linkejian123/G9_UofTSARBot/src/Top_Level_Design/bd/Top_Level_Design_BD/hdl/Top_Level_Design_BD.v

//Copyright 1986-2016 Xilinx, Inc. All Rights Reserved.
//--------------------------------------------------------------------------------
//Tool Version: Vivado v.2016.2 (win64) Build 1577090 Thu Jun  2 16:32:40 MDT 2016
//Date        : Mon Apr 10 12:14:05 2017
//Host        : DESKTOP-RL33AL7 running 64-bit major release  (build 9200)
//Command     : generate_target Top_Level_Design_BD.bd
//Design      : Top_Level_Design_BD
//Purpose     : IP block netlist
//--------------------------------------------------------------------------------
`timescale 1 ps / 1 ps

(* CORE_GENERATION_INFO = "Top_Level_Design_BD,IP_Integrator,{x_ipVendor=xilinx.com,x_ipLibrary=BlockDiagram,x_ipName=Top_Level_Design_BD,x_ipVersion=1.00.a,x_ipLanguage=VERILOG,numBlks=30,numReposBlks=19,numNonXlnxBlks=0,numHierBlks=11,maxHierDepth=1,numSysgenBlks=0,numHlsBlks=0,numHdlrefBlks=0,numPkgbdBlks=0,bdsource=USER,da_axi4_cnt=8,da_board_cnt=5,da_mb_cnt=1,synth_mode=Global}" *) (* HW_HANDOFF = "Top_Level_Design_BD.hwdef" *) 
module Top_Level_Design_BD
   (OV7670_D,
    OV7670_HREF,
    OV7670_PCLK,
    OV7670_PWDN,
    OV7670_RESET,
    OV7670_SIOC,
    OV7670_SIOD,
    OV7670_VSYNC,
    OV7670_XCLK,
    TMP_SCL,
    TMP_SDA,
    VGA_Blue,
    VGA_Green,
    VGA_HSYNC,
    VGA_MODE,
    VGA_Red,
    VGA_VSYNC,
    clock_rtl,
    miso,
    mosi,
    reset_rtl,
    reset_rtl_0,
    robot_wheel_driver_1,
    robot_wheel_driver_2,
    robot_wheel_driver_3,
    robot_wheel_driver_4,
    sclk,
    ss,
    uart_rtl_0_rxd,
    uart_rtl_0_txd,
    uart_rtl_rxd,
    uart_rtl_txd,
    vauxn10,
    vauxn11,
    vauxn2,
    vauxn3,
    vauxp10,
    vauxp11,
    vauxp2,
    vauxp3,
    vn_in,
    vp_in);
  input [7:0]OV7670_D;
  input OV7670_HREF;
  input OV7670_PCLK;
  output OV7670_PWDN;
  output OV7670_RESET;
  output OV7670_SIOC;
  inout OV7670_SIOD;
  input OV7670_VSYNC;
  output OV7670_XCLK;
  inout TMP_SCL;
  inout TMP_SDA;
  output [3:0]VGA_Blue;
  output [3:0]VGA_Green;
  output VGA_HSYNC;
  input VGA_MODE;
  output [3:0]VGA_Red;
  output VGA_VSYNC;
  input clock_rtl;
  input miso;
  output mosi;
  input reset_rtl;
  input reset_rtl_0;
  output [1:0]robot_wheel_driver_1;
  output [1:0]robot_wheel_driver_2;
  output [1:0]robot_wheel_driver_3;
  output [1:0]robot_wheel_driver_4;
  output sclk;
  output ss;
  input uart_rtl_0_rxd;
  output uart_rtl_0_txd;
  input uart_rtl_rxd;
  output uart_rtl_txd;
  input vauxn10;
  input vauxn11;
  input vauxn2;
  input vauxn3;
  input vauxp10;
  input vauxp11;
  input vauxp2;
  input vauxp3;
  input vn_in;
  input vp_in;

  wire Accelerometer_0_mosi;
  wire Accelerometer_0_sclk;
  wire Accelerometer_0_ss;
  wire Net;
  wire Net1;
  wire Net2;
  wire [7:0]OV7670_D_1;
  wire OV7670_HREF_1;
  wire OV7670_PCLK_1;
  wire OV7670_VGA_0_OV7670_PWDN;
  wire OV7670_VGA_0_OV7670_RESET;
  wire OV7670_VGA_0_OV7670_SIOC;
  wire OV7670_VGA_0_OV7670_XCLK;
  wire [3:0]OV7670_VGA_0_VGA_Blue;
  wire [3:0]OV7670_VGA_0_VGA_Green;
  wire OV7670_VGA_0_VGA_HSYNC;
  wire [3:0]OV7670_VGA_0_VGA_Red;
  wire OV7670_VGA_0_VGA_VSYNC;
  wire OV7670_VSYNC_1;
  wire [1:0]Robot_Controller_0_robot_wheel_driver_1;
  wire [1:0]Robot_Controller_0_robot_wheel_driver_2;
  wire [1:0]Robot_Controller_0_robot_wheel_driver_3;
  wire [1:0]Robot_Controller_0_robot_wheel_driver_4;
  wire VGA_MODE_1;
  wire axi_uartlite_0_UART_RxD;
  wire axi_uartlite_0_UART_TxD;
  wire axi_uartlite_0_interrupt;
  wire axi_uartlite_1_UART_RxD;
  wire axi_uartlite_1_UART_TxD;
  wire axi_uartlite_1_interrupt;
  wire clk_wiz_1_locked;
  wire clock_rtl_1;
  wire mdm_1_debug_sys_rst;
  wire microblaze_0_Clk;
  wire [31:0]microblaze_0_axi_dp_ARADDR;
  wire [2:0]microblaze_0_axi_dp_ARPROT;
  wire [0:0]microblaze_0_axi_dp_ARREADY;
  wire microblaze_0_axi_dp_ARVALID;
  wire [31:0]microblaze_0_axi_dp_AWADDR;
  wire [2:0]microblaze_0_axi_dp_AWPROT;
  wire [0:0]microblaze_0_axi_dp_AWREADY;
  wire microblaze_0_axi_dp_AWVALID;
  wire microblaze_0_axi_dp_BREADY;
  wire [1:0]microblaze_0_axi_dp_BRESP;
  wire [0:0]microblaze_0_axi_dp_BVALID;
  wire [31:0]microblaze_0_axi_dp_RDATA;
  wire microblaze_0_axi_dp_RREADY;
  wire [1:0]microblaze_0_axi_dp_RRESP;
  wire [0:0]microblaze_0_axi_dp_RVALID;
  wire [31:0]microblaze_0_axi_dp_WDATA;
  wire [0:0]microblaze_0_axi_dp_WREADY;
  wire [3:0]microblaze_0_axi_dp_WSTRB;
  wire microblaze_0_axi_dp_WVALID;
  wire [31:0]microblaze_0_axi_periph_M01_AXI_ARADDR;
  wire [2:0]microblaze_0_axi_periph_M01_AXI_ARPROT;
  wire microblaze_0_axi_periph_M01_AXI_ARREADY;
  wire microblaze_0_axi_periph_M01_AXI_ARVALID;
  wire [31:0]microblaze_0_axi_periph_M01_AXI_AWADDR;
  wire [2:0]microblaze_0_axi_periph_M01_AXI_AWPROT;
  wire microblaze_0_axi_periph_M01_AXI_AWREADY;
  wire microblaze_0_axi_periph_M01_AXI_AWVALID;
  wire microblaze_0_axi_periph_M01_AXI_BREADY;
  wire [1:0]microblaze_0_axi_periph_M01_AXI_BRESP;
  wire microblaze_0_axi_periph_M01_AXI_BVALID;
  wire [31:0]microblaze_0_axi_periph_M01_AXI_RDATA;
  wire microblaze_0_axi_periph_M01_AXI_RREADY;
  wire [1:0]microblaze_0_axi_periph_M01_AXI_RRESP;
  wire microblaze_0_axi_periph_M01_AXI_RVALID;
  wire [31:0]microblaze_0_axi_periph_M01_AXI_WDATA;
  wire microblaze_0_axi_periph_M01_AXI_WREADY;
  wire [3:0]microblaze_0_axi_periph_M01_AXI_WSTRB;
  wire microblaze_0_axi_periph_M01_AXI_WVALID;
  wire [31:0]microblaze_0_axi_periph_M02_AXI_ARADDR;
  wire [2:0]microblaze_0_axi_periph_M02_AXI_ARPROT;
  wire microblaze_0_axi_periph_M02_AXI_ARREADY;
  wire microblaze_0_axi_periph_M02_AXI_ARVALID;
  wire [31:0]microblaze_0_axi_periph_M02_AXI_AWADDR;
  wire [2:0]microblaze_0_axi_periph_M02_AXI_AWPROT;
  wire microblaze_0_axi_periph_M02_AXI_AWREADY;
  wire microblaze_0_axi_periph_M02_AXI_AWVALID;
  wire microblaze_0_axi_periph_M02_AXI_BREADY;
  wire [1:0]microblaze_0_axi_periph_M02_AXI_BRESP;
  wire microblaze_0_axi_periph_M02_AXI_BVALID;
  wire [31:0]microblaze_0_axi_periph_M02_AXI_RDATA;
  wire microblaze_0_axi_periph_M02_AXI_RREADY;
  wire [1:0]microblaze_0_axi_periph_M02_AXI_RRESP;
  wire microblaze_0_axi_periph_M02_AXI_RVALID;
  wire [31:0]microblaze_0_axi_periph_M02_AXI_WDATA;
  wire microblaze_0_axi_periph_M02_AXI_WREADY;
  wire [3:0]microblaze_0_axi_periph_M02_AXI_WSTRB;
  wire microblaze_0_axi_periph_M02_AXI_WVALID;
  wire [31:0]microblaze_0_axi_periph_M03_AXI_ARADDR;
  wire [2:0]microblaze_0_axi_periph_M03_AXI_ARPROT;
  wire microblaze_0_axi_periph_M03_AXI_ARREADY;
  wire microblaze_0_axi_periph_M03_AXI_ARVALID;
  wire [31:0]microblaze_0_axi_periph_M03_AXI_AWADDR;
  wire [2:0]microblaze_0_axi_periph_M03_AXI_AWPROT;
  wire microblaze_0_axi_periph_M03_AXI_AWREADY;
  wire microblaze_0_axi_periph_M03_AXI_AWVALID;
  wire microblaze_0_axi_periph_M03_AXI_BREADY;
  wire [1:0]microblaze_0_axi_periph_M03_AXI_BRESP;
  wire microblaze_0_axi_periph_M03_AXI_BVALID;
  wire [31:0]microblaze_0_axi_periph_M03_AXI_RDATA;
  wire microblaze_0_axi_periph_M03_AXI_RREADY;
  wire [1:0]microblaze_0_axi_periph_M03_AXI_RRESP;
  wire microblaze_0_axi_periph_M03_AXI_RVALID;
  wire [31:0]microblaze_0_axi_periph_M03_AXI_WDATA;
  wire microblaze_0_axi_periph_M03_AXI_WREADY;
  wire [3:0]microblaze_0_axi_periph_M03_AXI_WSTRB;
  wire microblaze_0_axi_periph_M03_AXI_WVALID;
  wire [31:0]microblaze_0_axi_periph_M04_AXI_ARADDR;
  wire [2:0]microblaze_0_axi_periph_M04_AXI_ARPROT;
  wire microblaze_0_axi_periph_M04_AXI_ARREADY;
  wire microblaze_0_axi_periph_M04_AXI_ARVALID;
  wire [31:0]microblaze_0_axi_periph_M04_AXI_AWADDR;
  wire [2:0]microblaze_0_axi_periph_M04_AXI_AWPROT;
  wire microblaze_0_axi_periph_M04_AXI_AWREADY;
  wire microblaze_0_axi_periph_M04_AXI_AWVALID;
  wire microblaze_0_axi_periph_M04_AXI_BREADY;
  wire [1:0]microblaze_0_axi_periph_M04_AXI_BRESP;
  wire microblaze_0_axi_periph_M04_AXI_BVALID;
  wire [31:0]microblaze_0_axi_periph_M04_AXI_RDATA;
  wire microblaze_0_axi_periph_M04_AXI_RREADY;
  wire [1:0]microblaze_0_axi_periph_M04_AXI_RRESP;
  wire microblaze_0_axi_periph_M04_AXI_RVALID;
  wire [31:0]microblaze_0_axi_periph_M04_AXI_WDATA;
  wire microblaze_0_axi_periph_M04_AXI_WREADY;
  wire [3:0]microblaze_0_axi_periph_M04_AXI_WSTRB;
  wire microblaze_0_axi_periph_M04_AXI_WVALID;
  wire [31:0]microblaze_0_axi_periph_M05_AXI_ARADDR;
  wire [2:0]microblaze_0_axi_periph_M05_AXI_ARPROT;
  wire microblaze_0_axi_periph_M05_AXI_ARREADY;
  wire microblaze_0_axi_periph_M05_AXI_ARVALID;
  wire [31:0]microblaze_0_axi_periph_M05_AXI_AWADDR;
  wire [2:0]microblaze_0_axi_periph_M05_AXI_AWPROT;
  wire microblaze_0_axi_periph_M05_AXI_AWREADY;
  wire microblaze_0_axi_periph_M05_AXI_AWVALID;
  wire microblaze_0_axi_periph_M05_AXI_BREADY;
  wire [1:0]microblaze_0_axi_periph_M05_AXI_BRESP;
  wire microblaze_0_axi_periph_M05_AXI_BVALID;
  wire [31:0]microblaze_0_axi_periph_M05_AXI_RDATA;
  wire microblaze_0_axi_periph_M05_AXI_RREADY;
  wire [1:0]microblaze_0_axi_periph_M05_AXI_RRESP;
  wire microblaze_0_axi_periph_M05_AXI_RVALID;
  wire [31:0]microblaze_0_axi_periph_M05_AXI_WDATA;
  wire microblaze_0_axi_periph_M05_AXI_WREADY;
  wire [3:0]microblaze_0_axi_periph_M05_AXI_WSTRB;
  wire microblaze_0_axi_periph_M05_AXI_WVALID;
  wire [31:0]microblaze_0_axi_periph_M06_AXI_ARADDR;
  wire microblaze_0_axi_periph_M06_AXI_ARREADY;
  wire microblaze_0_axi_periph_M06_AXI_ARVALID;
  wire [31:0]microblaze_0_axi_periph_M06_AXI_AWADDR;
  wire microblaze_0_axi_periph_M06_AXI_AWREADY;
  wire microblaze_0_axi_periph_M06_AXI_AWVALID;
  wire microblaze_0_axi_periph_M06_AXI_BREADY;
  wire [1:0]microblaze_0_axi_periph_M06_AXI_BRESP;
  wire microblaze_0_axi_periph_M06_AXI_BVALID;
  wire [31:0]microblaze_0_axi_periph_M06_AXI_RDATA;
  wire microblaze_0_axi_periph_M06_AXI_RREADY;
  wire [1:0]microblaze_0_axi_periph_M06_AXI_RRESP;
  wire microblaze_0_axi_periph_M06_AXI_RVALID;
  wire [31:0]microblaze_0_axi_periph_M06_AXI_WDATA;
  wire microblaze_0_axi_periph_M06_AXI_WREADY;
  wire [3:0]microblaze_0_axi_periph_M06_AXI_WSTRB;
  wire microblaze_0_axi_periph_M06_AXI_WVALID;
  wire [31:0]microblaze_0_axi_periph_M07_AXI_ARADDR;
  wire microblaze_0_axi_periph_M07_AXI_ARREADY;
  wire microblaze_0_axi_periph_M07_AXI_ARVALID;
  wire [31:0]microblaze_0_axi_periph_M07_AXI_AWADDR;
  wire microblaze_0_axi_periph_M07_AXI_AWREADY;
  wire microblaze_0_axi_periph_M07_AXI_AWVALID;
  wire microblaze_0_axi_periph_M07_AXI_BREADY;
  wire [1:0]microblaze_0_axi_periph_M07_AXI_BRESP;
  wire microblaze_0_axi_periph_M07_AXI_BVALID;
  wire [31:0]microblaze_0_axi_periph_M07_AXI_RDATA;
  wire microblaze_0_axi_periph_M07_AXI_RREADY;
  wire [1:0]microblaze_0_axi_periph_M07_AXI_RRESP;
  wire microblaze_0_axi_periph_M07_AXI_RVALID;
  wire [31:0]microblaze_0_axi_periph_M07_AXI_WDATA;
  wire microblaze_0_axi_periph_M07_AXI_WREADY;
  wire [3:0]microblaze_0_axi_periph_M07_AXI_WSTRB;
  wire microblaze_0_axi_periph_M07_AXI_WVALID;
  wire microblaze_0_debug_CAPTURE;
  wire microblaze_0_debug_CLK;
  wire [0:7]microblaze_0_debug_REG_EN;
  wire microblaze_0_debug_RST;
  wire microblaze_0_debug_SHIFT;
  wire microblaze_0_debug_TDI;
  wire microblaze_0_debug_TDO;
  wire microblaze_0_debug_UPDATE;
  wire [0:31]microblaze_0_dlmb_1_ABUS;
  wire microblaze_0_dlmb_1_ADDRSTROBE;
  wire [0:3]microblaze_0_dlmb_1_BE;
  wire microblaze_0_dlmb_1_CE;
  wire [0:31]microblaze_0_dlmb_1_READDBUS;
  wire microblaze_0_dlmb_1_READSTROBE;
  wire microblaze_0_dlmb_1_READY;
  wire microblaze_0_dlmb_1_UE;
  wire microblaze_0_dlmb_1_WAIT;
  wire [0:31]microblaze_0_dlmb_1_WRITEDBUS;
  wire microblaze_0_dlmb_1_WRITESTROBE;
  wire [0:31]microblaze_0_ilmb_1_ABUS;
  wire microblaze_0_ilmb_1_ADDRSTROBE;
  wire microblaze_0_ilmb_1_CE;
  wire [0:31]microblaze_0_ilmb_1_READDBUS;
  wire microblaze_0_ilmb_1_READSTROBE;
  wire microblaze_0_ilmb_1_READY;
  wire microblaze_0_ilmb_1_UE;
  wire microblaze_0_ilmb_1_WAIT;
  wire [31:0]microblaze_0_intc_axi_ARADDR;
  wire microblaze_0_intc_axi_ARREADY;
  wire microblaze_0_intc_axi_ARVALID;
  wire [31:0]microblaze_0_intc_axi_AWADDR;
  wire microblaze_0_intc_axi_AWREADY;
  wire microblaze_0_intc_axi_AWVALID;
  wire microblaze_0_intc_axi_BREADY;
  wire [1:0]microblaze_0_intc_axi_BRESP;
  wire microblaze_0_intc_axi_BVALID;
  wire [31:0]microblaze_0_intc_axi_RDATA;
  wire microblaze_0_intc_axi_RREADY;
  wire [1:0]microblaze_0_intc_axi_RRESP;
  wire microblaze_0_intc_axi_RVALID;
  wire [31:0]microblaze_0_intc_axi_WDATA;
  wire microblaze_0_intc_axi_WREADY;
  wire [3:0]microblaze_0_intc_axi_WSTRB;
  wire microblaze_0_intc_axi_WVALID;
  wire [0:1]microblaze_0_interrupt_ACK;
  wire [31:0]microblaze_0_interrupt_ADDRESS;
  wire microblaze_0_interrupt_INTERRUPT;
  wire [1:0]microblaze_0_intr;
  wire miso_1;
  wire reset_rtl_0_1;
  wire reset_rtl_1;
  wire [0:0]rst_clk_wiz_1_100M_bus_struct_reset;
  wire [0:0]rst_clk_wiz_1_100M_interconnect_aresetn;
  wire rst_clk_wiz_1_100M_mb_reset;
  wire [0:0]rst_clk_wiz_1_100M_peripheral_aresetn;
  wire vauxn10_1;
  wire vauxn11_1;
  wire vauxn2_1;
  wire vauxn3_1;
  wire vauxp10_1;
  wire vauxp11_1;
  wire vauxp2_1;
  wire vauxp3_1;
  wire vn_in_1;
  wire vp_in_1;

  assign OV7670_D_1 = OV7670_D[7:0];
  assign OV7670_HREF_1 = OV7670_HREF;
  assign OV7670_PCLK_1 = OV7670_PCLK;
  assign OV7670_PWDN = OV7670_VGA_0_OV7670_PWDN;
  assign OV7670_RESET = OV7670_VGA_0_OV7670_RESET;
  assign OV7670_SIOC = OV7670_VGA_0_OV7670_SIOC;
  assign OV7670_VSYNC_1 = OV7670_VSYNC;
  assign OV7670_XCLK = OV7670_VGA_0_OV7670_XCLK;
  assign VGA_Blue[3:0] = OV7670_VGA_0_VGA_Blue;
  assign VGA_Green[3:0] = OV7670_VGA_0_VGA_Green;
  assign VGA_HSYNC = OV7670_VGA_0_VGA_HSYNC;
  assign VGA_MODE_1 = VGA_MODE;
  assign VGA_Red[3:0] = OV7670_VGA_0_VGA_Red;
  assign VGA_VSYNC = OV7670_VGA_0_VGA_VSYNC;
  assign axi_uartlite_0_UART_RxD = uart_rtl_rxd;
  assign axi_uartlite_1_UART_RxD = uart_rtl_0_rxd;
  assign clock_rtl_1 = clock_rtl;
  assign miso_1 = miso;
  assign mosi = Accelerometer_0_mosi;
  assign reset_rtl_0_1 = reset_rtl_0;
  assign reset_rtl_1 = reset_rtl;
  assign robot_wheel_driver_1[1:0] = Robot_Controller_0_robot_wheel_driver_1;
  assign robot_wheel_driver_2[1:0] = Robot_Controller_0_robot_wheel_driver_2;
  assign robot_wheel_driver_3[1:0] = Robot_Controller_0_robot_wheel_driver_3;
  assign robot_wheel_driver_4[1:0] = Robot_Controller_0_robot_wheel_driver_4;
  assign sclk = Accelerometer_0_sclk;
  assign ss = Accelerometer_0_ss;
  assign uart_rtl_0_txd = axi_uartlite_1_UART_TxD;
  assign uart_rtl_txd = axi_uartlite_0_UART_TxD;
  assign vauxn10_1 = vauxn10;
  assign vauxn11_1 = vauxn11;
  assign vauxn2_1 = vauxn2;
  assign vauxn3_1 = vauxn3;
  assign vauxp10_1 = vauxp10;
  assign vauxp11_1 = vauxp11;
  assign vauxp2_1 = vauxp2;
  assign vauxp3_1 = vauxp3;
  assign vn_in_1 = vn_in;
  assign vp_in_1 = vp_in;
  Top_Level_Design_BD_Accelerometer_0_0 Accelerometer_0
       (.accelerometer_axi_aclk(microblaze_0_Clk),
        .accelerometer_axi_araddr(microblaze_0_axi_periph_M04_AXI_ARADDR[3:0]),
        .accelerometer_axi_aresetn(rst_clk_wiz_1_100M_peripheral_aresetn),
        .accelerometer_axi_arprot(microblaze_0_axi_periph_M04_AXI_ARPROT),
        .accelerometer_axi_arready(microblaze_0_axi_periph_M04_AXI_ARREADY),
        .accelerometer_axi_arvalid(microblaze_0_axi_periph_M04_AXI_ARVALID),
        .accelerometer_axi_awaddr(microblaze_0_axi_periph_M04_AXI_AWADDR[3:0]),
        .accelerometer_axi_awprot(microblaze_0_axi_periph_M04_AXI_AWPROT),
        .accelerometer_axi_awready(microblaze_0_axi_periph_M04_AXI_AWREADY),
        .accelerometer_axi_awvalid(microblaze_0_axi_periph_M04_AXI_AWVALID),
        .accelerometer_axi_bready(microblaze_0_axi_periph_M04_AXI_BREADY),
        .accelerometer_axi_bresp(microblaze_0_axi_periph_M04_AXI_BRESP),
        .accelerometer_axi_bvalid(microblaze_0_axi_periph_M04_AXI_BVALID),
        .accelerometer_axi_rdata(microblaze_0_axi_periph_M04_AXI_RDATA),
        .accelerometer_axi_rready(microblaze_0_axi_periph_M04_AXI_RREADY),
        .accelerometer_axi_rresp(microblaze_0_axi_periph_M04_AXI_RRESP),
        .accelerometer_axi_rvalid(microblaze_0_axi_periph_M04_AXI_RVALID),
        .accelerometer_axi_wdata(microblaze_0_axi_periph_M04_AXI_WDATA),
        .accelerometer_axi_wready(microblaze_0_axi_periph_M04_AXI_WREADY),
        .accelerometer_axi_wstrb(microblaze_0_axi_periph_M04_AXI_WSTRB),
        .accelerometer_axi_wvalid(microblaze_0_axi_periph_M04_AXI_WVALID),
        .miso(miso_1),
        .mosi(Accelerometer_0_mosi),
        .sclk(Accelerometer_0_sclk),
        .ss(Accelerometer_0_ss));
  Top_Level_Design_BD_OV7670_VGA_0_0 OV7670_VGA_0
       (.OV7670_D(OV7670_D_1),
        .OV7670_HREF(OV7670_HREF_1),
        .OV7670_PCLK(OV7670_PCLK_1),
        .OV7670_PWDN(OV7670_VGA_0_OV7670_PWDN),
        .OV7670_RESET(OV7670_VGA_0_OV7670_RESET),
        .OV7670_SIOC(OV7670_VGA_0_OV7670_SIOC),
        .OV7670_SIOD(OV7670_SIOD),
        .OV7670_VSYNC(OV7670_VSYNC_1),
        .OV7670_XCLK(OV7670_VGA_0_OV7670_XCLK),
        .VGA_Blue(OV7670_VGA_0_VGA_Blue),
        .VGA_Green(OV7670_VGA_0_VGA_Green),
        .VGA_HSYNC(OV7670_VGA_0_VGA_HSYNC),
        .VGA_MODE(VGA_MODE_1),
        .VGA_Red(OV7670_VGA_0_VGA_Red),
        .VGA_VSYNC(OV7670_VGA_0_VGA_VSYNC),
        .ov7670_vga_axi_aclk(microblaze_0_Clk),
        .ov7670_vga_axi_araddr(microblaze_0_axi_periph_M02_AXI_ARADDR[3:0]),
        .ov7670_vga_axi_aresetn(rst_clk_wiz_1_100M_peripheral_aresetn),
        .ov7670_vga_axi_arprot(microblaze_0_axi_periph_M02_AXI_ARPROT),
        .ov7670_vga_axi_arready(microblaze_0_axi_periph_M02_AXI_ARREADY),
        .ov7670_vga_axi_arvalid(microblaze_0_axi_periph_M02_AXI_ARVALID),
        .ov7670_vga_axi_awaddr(microblaze_0_axi_periph_M02_AXI_AWADDR[3:0]),
        .ov7670_vga_axi_awprot(microblaze_0_axi_periph_M02_AXI_AWPROT),
        .ov7670_vga_axi_awready(microblaze_0_axi_periph_M02_AXI_AWREADY),
        .ov7670_vga_axi_awvalid(microblaze_0_axi_periph_M02_AXI_AWVALID),
        .ov7670_vga_axi_bready(microblaze_0_axi_periph_M02_AXI_BREADY),
        .ov7670_vga_axi_bresp(microblaze_0_axi_periph_M02_AXI_BRESP),
        .ov7670_vga_axi_bvalid(microblaze_0_axi_periph_M02_AXI_BVALID),
        .ov7670_vga_axi_rdata(microblaze_0_axi_periph_M02_AXI_RDATA),
        .ov7670_vga_axi_rready(microblaze_0_axi_periph_M02_AXI_RREADY),
        .ov7670_vga_axi_rresp(microblaze_0_axi_periph_M02_AXI_RRESP),
        .ov7670_vga_axi_rvalid(microblaze_0_axi_periph_M02_AXI_RVALID),
        .ov7670_vga_axi_wdata(microblaze_0_axi_periph_M02_AXI_WDATA),
        .ov7670_vga_axi_wready(microblaze_0_axi_periph_M02_AXI_WREADY),
        .ov7670_vga_axi_wstrb(microblaze_0_axi_periph_M02_AXI_WSTRB),
        .ov7670_vga_axi_wvalid(microblaze_0_axi_periph_M02_AXI_WVALID));
  Top_Level_Design_BD_Robot_Controller_0_0 Robot_Controller_0
       (.robot_controller_axi_aclk(microblaze_0_Clk),
        .robot_controller_axi_araddr(microblaze_0_axi_periph_M01_AXI_ARADDR[4:0]),
        .robot_controller_axi_aresetn(rst_clk_wiz_1_100M_peripheral_aresetn),
        .robot_controller_axi_arprot(microblaze_0_axi_periph_M01_AXI_ARPROT),
        .robot_controller_axi_arready(microblaze_0_axi_periph_M01_AXI_ARREADY),
        .robot_controller_axi_arvalid(microblaze_0_axi_periph_M01_AXI_ARVALID),
        .robot_controller_axi_awaddr(microblaze_0_axi_periph_M01_AXI_AWADDR[4:0]),
        .robot_controller_axi_awprot(microblaze_0_axi_periph_M01_AXI_AWPROT),
        .robot_controller_axi_awready(microblaze_0_axi_periph_M01_AXI_AWREADY),
        .robot_controller_axi_awvalid(microblaze_0_axi_periph_M01_AXI_AWVALID),
        .robot_controller_axi_bready(microblaze_0_axi_periph_M01_AXI_BREADY),
        .robot_controller_axi_bresp(microblaze_0_axi_periph_M01_AXI_BRESP),
        .robot_controller_axi_bvalid(microblaze_0_axi_periph_M01_AXI_BVALID),
        .robot_controller_axi_rdata(microblaze_0_axi_periph_M01_AXI_RDATA),
        .robot_controller_axi_rready(microblaze_0_axi_periph_M01_AXI_RREADY),
        .robot_controller_axi_rresp(microblaze_0_axi_periph_M01_AXI_RRESP),
        .robot_controller_axi_rvalid(microblaze_0_axi_periph_M01_AXI_RVALID),
        .robot_controller_axi_wdata(microblaze_0_axi_periph_M01_AXI_WDATA),
        .robot_controller_axi_wready(microblaze_0_axi_periph_M01_AXI_WREADY),
        .robot_controller_axi_wstrb(microblaze_0_axi_periph_M01_AXI_WSTRB),
        .robot_controller_axi_wvalid(microblaze_0_axi_periph_M01_AXI_WVALID),
        .robot_wheel_driver_1(Robot_Controller_0_robot_wheel_driver_1),
        .robot_wheel_driver_2(Robot_Controller_0_robot_wheel_driver_2),
        .robot_wheel_driver_3(Robot_Controller_0_robot_wheel_driver_3),
        .robot_wheel_driver_4(Robot_Controller_0_robot_wheel_driver_4));
  Top_Level_Design_BD_Temp_Sensor_0_0 Temp_Sensor_0
       (.TMP_SCL(TMP_SCL),
        .TMP_SDA(TMP_SDA),
        .temp_sensor_axi_aclk(microblaze_0_Clk),
        .temp_sensor_axi_araddr(microblaze_0_axi_periph_M03_AXI_ARADDR[3:0]),
        .temp_sensor_axi_aresetn(rst_clk_wiz_1_100M_peripheral_aresetn),
        .temp_sensor_axi_arprot(microblaze_0_axi_periph_M03_AXI_ARPROT),
        .temp_sensor_axi_arready(microblaze_0_axi_periph_M03_AXI_ARREADY),
        .temp_sensor_axi_arvalid(microblaze_0_axi_periph_M03_AXI_ARVALID),
        .temp_sensor_axi_awaddr(microblaze_0_axi_periph_M03_AXI_AWADDR[3:0]),
        .temp_sensor_axi_awprot(microblaze_0_axi_periph_M03_AXI_AWPROT),
        .temp_sensor_axi_awready(microblaze_0_axi_periph_M03_AXI_AWREADY),
        .temp_sensor_axi_awvalid(microblaze_0_axi_periph_M03_AXI_AWVALID),
        .temp_sensor_axi_bready(microblaze_0_axi_periph_M03_AXI_BREADY),
        .temp_sensor_axi_bresp(microblaze_0_axi_periph_M03_AXI_BRESP),
        .temp_sensor_axi_bvalid(microblaze_0_axi_periph_M03_AXI_BVALID),
        .temp_sensor_axi_rdata(microblaze_0_axi_periph_M03_AXI_RDATA),
        .temp_sensor_axi_rready(microblaze_0_axi_periph_M03_AXI_RREADY),
        .temp_sensor_axi_rresp(microblaze_0_axi_periph_M03_AXI_RRESP),
        .temp_sensor_axi_rvalid(microblaze_0_axi_periph_M03_AXI_RVALID),
        .temp_sensor_axi_wdata(microblaze_0_axi_periph_M03_AXI_WDATA),
        .temp_sensor_axi_wready(microblaze_0_axi_periph_M03_AXI_WREADY),
        .temp_sensor_axi_wstrb(microblaze_0_axi_periph_M03_AXI_WSTRB),
        .temp_sensor_axi_wvalid(microblaze_0_axi_periph_M03_AXI_WVALID));
  Top_Level_Design_BD_XADC_0_1 XADC_0
       (.vauxn10(vauxn10_1),
        .vauxn11(vauxn11_1),
        .vauxn2(vauxn2_1),
        .vauxn3(vauxn3_1),
        .vauxp10(vauxp10_1),
        .vauxp11(vauxp11_1),
        .vauxp2(vauxp2_1),
        .vauxp3(vauxp3_1),
        .vn_in(vn_in_1),
        .vp_in(vp_in_1),
        .xadc_axi_aclk(microblaze_0_Clk),
        .xadc_axi_araddr(microblaze_0_axi_periph_M05_AXI_ARADDR[3:0]),
        .xadc_axi_aresetn(rst_clk_wiz_1_100M_peripheral_aresetn),
        .xadc_axi_arprot(microblaze_0_axi_periph_M05_AXI_ARPROT),
        .xadc_axi_arready(microblaze_0_axi_periph_M05_AXI_ARREADY),
        .xadc_axi_arvalid(microblaze_0_axi_periph_M05_AXI_ARVALID),
        .xadc_axi_awaddr(microblaze_0_axi_periph_M05_AXI_AWADDR[3:0]),
        .xadc_axi_awprot(microblaze_0_axi_periph_M05_AXI_AWPROT),
        .xadc_axi_awready(microblaze_0_axi_periph_M05_AXI_AWREADY),
        .xadc_axi_awvalid(microblaze_0_axi_periph_M05_AXI_AWVALID),
        .xadc_axi_bready(microblaze_0_axi_periph_M05_AXI_BREADY),
        .xadc_axi_bresp(microblaze_0_axi_periph_M05_AXI_BRESP),
        .xadc_axi_bvalid(microblaze_0_axi_periph_M05_AXI_BVALID),
        .xadc_axi_rdata(microblaze_0_axi_periph_M05_AXI_RDATA),
        .xadc_axi_rready(microblaze_0_axi_periph_M05_AXI_RREADY),
        .xadc_axi_rresp(microblaze_0_axi_periph_M05_AXI_RRESP),
        .xadc_axi_rvalid(microblaze_0_axi_periph_M05_AXI_RVALID),
        .xadc_axi_wdata(microblaze_0_axi_periph_M05_AXI_WDATA),
        .xadc_axi_wready(microblaze_0_axi_periph_M05_AXI_WREADY),
        .xadc_axi_wstrb(microblaze_0_axi_periph_M05_AXI_WSTRB),
        .xadc_axi_wvalid(microblaze_0_axi_periph_M05_AXI_WVALID));
  Top_Level_Design_BD_axi_uartlite_0_0 axi_uartlite_0
       (.interrupt(axi_uartlite_0_interrupt),
        .rx(axi_uartlite_0_UART_RxD),
        .s_axi_aclk(microblaze_0_Clk),
        .s_axi_araddr(microblaze_0_axi_periph_M06_AXI_ARADDR[3:0]),
        .s_axi_aresetn(rst_clk_wiz_1_100M_peripheral_aresetn),
        .s_axi_arready(microblaze_0_axi_periph_M06_AXI_ARREADY),
        .s_axi_arvalid(microblaze_0_axi_periph_M06_AXI_ARVALID),
        .s_axi_awaddr(microblaze_0_axi_periph_M06_AXI_AWADDR[3:0]),
        .s_axi_awready(microblaze_0_axi_periph_M06_AXI_AWREADY),
        .s_axi_awvalid(microblaze_0_axi_periph_M06_AXI_AWVALID),
        .s_axi_bready(microblaze_0_axi_periph_M06_AXI_BREADY),
        .s_axi_bresp(microblaze_0_axi_periph_M06_AXI_BRESP),
        .s_axi_bvalid(microblaze_0_axi_periph_M06_AXI_BVALID),
        .s_axi_rdata(microblaze_0_axi_periph_M06_AXI_RDATA),
        .s_axi_rready(microblaze_0_axi_periph_M06_AXI_RREADY),
        .s_axi_rresp(microblaze_0_axi_periph_M06_AXI_RRESP),
        .s_axi_rvalid(microblaze_0_axi_periph_M06_AXI_RVALID),
        .s_axi_wdata(microblaze_0_axi_periph_M06_AXI_WDATA),
        .s_axi_wready(microblaze_0_axi_periph_M06_AXI_WREADY),
        .s_axi_wstrb(microblaze_0_axi_periph_M06_AXI_WSTRB),
        .s_axi_wvalid(microblaze_0_axi_periph_M06_AXI_WVALID),
        .tx(axi_uartlite_0_UART_TxD));
  Top_Level_Design_BD_axi_uartlite_1_0 axi_uartlite_1
       (.interrupt(axi_uartlite_1_interrupt),
        .rx(axi_uartlite_1_UART_RxD),
        .s_axi_aclk(microblaze_0_Clk),
        .s_axi_araddr(microblaze_0_axi_periph_M07_AXI_ARADDR[3:0]),
        .s_axi_aresetn(rst_clk_wiz_1_100M_peripheral_aresetn),
        .s_axi_arready(microblaze_0_axi_periph_M07_AXI_ARREADY),
        .s_axi_arvalid(microblaze_0_axi_periph_M07_AXI_ARVALID),
        .s_axi_awaddr(microblaze_0_axi_periph_M07_AXI_AWADDR[3:0]),
        .s_axi_awready(microblaze_0_axi_periph_M07_AXI_AWREADY),
        .s_axi_awvalid(microblaze_0_axi_periph_M07_AXI_AWVALID),
        .s_axi_bready(microblaze_0_axi_periph_M07_AXI_BREADY),
        .s_axi_bresp(microblaze_0_axi_periph_M07_AXI_BRESP),
        .s_axi_bvalid(microblaze_0_axi_periph_M07_AXI_BVALID),
        .s_axi_rdata(microblaze_0_axi_periph_M07_AXI_RDATA),
        .s_axi_rready(microblaze_0_axi_periph_M07_AXI_RREADY),
        .s_axi_rresp(microblaze_0_axi_periph_M07_AXI_RRESP),
        .s_axi_rvalid(microblaze_0_axi_periph_M07_AXI_RVALID),
        .s_axi_wdata(microblaze_0_axi_periph_M07_AXI_WDATA),
        .s_axi_wready(microblaze_0_axi_periph_M07_AXI_WREADY),
        .s_axi_wstrb(microblaze_0_axi_periph_M07_AXI_WSTRB),
        .s_axi_wvalid(microblaze_0_axi_periph_M07_AXI_WVALID),
        .tx(axi_uartlite_1_UART_TxD));
  Top_Level_Design_BD_clk_wiz_1_0 clk_wiz_1
       (.clk_in1(clock_rtl_1),
        .clk_out1(microblaze_0_Clk),
        .locked(clk_wiz_1_locked),
        .resetn(reset_rtl_1));
  Top_Level_Design_BD_mdm_1_0 mdm_1
       (.Dbg_Capture_0(microblaze_0_debug_CAPTURE),
        .Dbg_Clk_0(microblaze_0_debug_CLK),
        .Dbg_Reg_En_0(microblaze_0_debug_REG_EN),
        .Dbg_Rst_0(microblaze_0_debug_RST),
        .Dbg_Shift_0(microblaze_0_debug_SHIFT),
        .Dbg_TDI_0(microblaze_0_debug_TDI),
        .Dbg_TDO_0(microblaze_0_debug_TDO),
        .Dbg_Update_0(microblaze_0_debug_UPDATE),
        .Debug_SYS_Rst(mdm_1_debug_sys_rst));
  (* BMM_INFO_PROCESSOR = "microblaze-le > Top_Level_Design_BD microblaze_0_local_memory/dlmb_bram_if_cntlr" *) 
  (* KEEP_HIERARCHY = "yes" *) 
  Top_Level_Design_BD_microblaze_0_0 microblaze_0
       (.Byte_Enable(microblaze_0_dlmb_1_BE),
        .Clk(microblaze_0_Clk),
        .DCE(microblaze_0_dlmb_1_CE),
        .DReady(microblaze_0_dlmb_1_READY),
        .DUE(microblaze_0_dlmb_1_UE),
        .DWait(microblaze_0_dlmb_1_WAIT),
        .D_AS(microblaze_0_dlmb_1_ADDRSTROBE),
        .Data_Addr(microblaze_0_dlmb_1_ABUS),
        .Data_Read(microblaze_0_dlmb_1_READDBUS),
        .Data_Write(microblaze_0_dlmb_1_WRITEDBUS),
        .Dbg_Capture(microblaze_0_debug_CAPTURE),
        .Dbg_Clk(microblaze_0_debug_CLK),
        .Dbg_Reg_En(microblaze_0_debug_REG_EN),
        .Dbg_Shift(microblaze_0_debug_SHIFT),
        .Dbg_TDI(microblaze_0_debug_TDI),
        .Dbg_TDO(microblaze_0_debug_TDO),
        .Dbg_Update(microblaze_0_debug_UPDATE),
        .Debug_Rst(microblaze_0_debug_RST),
        .ICE(microblaze_0_ilmb_1_CE),
        .IFetch(microblaze_0_ilmb_1_READSTROBE),
        .IReady(microblaze_0_ilmb_1_READY),
        .IUE(microblaze_0_ilmb_1_UE),
        .IWAIT(microblaze_0_ilmb_1_WAIT),
        .I_AS(microblaze_0_ilmb_1_ADDRSTROBE),
        .Instr(microblaze_0_ilmb_1_READDBUS),
        .Instr_Addr(microblaze_0_ilmb_1_ABUS),
        .Interrupt(microblaze_0_interrupt_INTERRUPT),
        .Interrupt_Ack(microblaze_0_interrupt_ACK),
        .Interrupt_Address({microblaze_0_interrupt_ADDRESS[31],microblaze_0_interrupt_ADDRESS[30],microblaze_0_interrupt_ADDRESS[29],microblaze_0_interrupt_ADDRESS[28],microblaze_0_interrupt_ADDRESS[27],microblaze_0_interrupt_ADDRESS[26],microblaze_0_interrupt_ADDRESS[25],microblaze_0_interrupt_ADDRESS[24],microblaze_0_interrupt_ADDRESS[23],microblaze_0_interrupt_ADDRESS[22],microblaze_0_interrupt_ADDRESS[21],microblaze_0_interrupt_ADDRESS[20],microblaze_0_interrupt_ADDRESS[19],microblaze_0_interrupt_ADDRESS[18],microblaze_0_interrupt_ADDRESS[17],microblaze_0_interrupt_ADDRESS[16],microblaze_0_interrupt_ADDRESS[15],microblaze_0_interrupt_ADDRESS[14],microblaze_0_interrupt_ADDRESS[13],microblaze_0_interrupt_ADDRESS[12],microblaze_0_interrupt_ADDRESS[11],microblaze_0_interrupt_ADDRESS[10],microblaze_0_interrupt_ADDRESS[9],microblaze_0_interrupt_ADDRESS[8],microblaze_0_interrupt_ADDRESS[7],microblaze_0_interrupt_ADDRESS[6],microblaze_0_interrupt_ADDRESS[5],microblaze_0_interrupt_ADDRESS[4],microblaze_0_interrupt_ADDRESS[3],microblaze_0_interrupt_ADDRESS[2],microblaze_0_interrupt_ADDRESS[1],microblaze_0_interrupt_ADDRESS[0]}),
        .M_AXI_DP_ARADDR(microblaze_0_axi_dp_ARADDR),
        .M_AXI_DP_ARPROT(microblaze_0_axi_dp_ARPROT),
        .M_AXI_DP_ARREADY(microblaze_0_axi_dp_ARREADY),
        .M_AXI_DP_ARVALID(microblaze_0_axi_dp_ARVALID),
        .M_AXI_DP_AWADDR(microblaze_0_axi_dp_AWADDR),
        .M_AXI_DP_AWPROT(microblaze_0_axi_dp_AWPROT),
        .M_AXI_DP_AWREADY(microblaze_0_axi_dp_AWREADY),
        .M_AXI_DP_AWVALID(microblaze_0_axi_dp_AWVALID),
        .M_AXI_DP_BREADY(microblaze_0_axi_dp_BREADY),
        .M_AXI_DP_BRESP(microblaze_0_axi_dp_BRESP),
        .M_AXI_DP_BVALID(microblaze_0_axi_dp_BVALID),
        .M_AXI_DP_RDATA(microblaze_0_axi_dp_RDATA),
        .M_AXI_DP_RREADY(microblaze_0_axi_dp_RREADY),
        .M_AXI_DP_RRESP(microblaze_0_axi_dp_RRESP),
        .M_AXI_DP_RVALID(microblaze_0_axi_dp_RVALID),
        .M_AXI_DP_WDATA(microblaze_0_axi_dp_WDATA),
        .M_AXI_DP_WREADY(microblaze_0_axi_dp_WREADY),
        .M_AXI_DP_WSTRB(microblaze_0_axi_dp_WSTRB),
        .M_AXI_DP_WVALID(microblaze_0_axi_dp_WVALID),
        .Read_Strobe(microblaze_0_dlmb_1_READSTROBE),
        .Reset(rst_clk_wiz_1_100M_mb_reset),
        .Write_Strobe(microblaze_0_dlmb_1_WRITESTROBE));
  Top_Level_Design_BD_microblaze_0_axi_intc_0 microblaze_0_axi_intc
       (.interrupt_address(microblaze_0_interrupt_ADDRESS),
        .intr(microblaze_0_intr),
        .irq(microblaze_0_interrupt_INTERRUPT),
        .processor_ack({microblaze_0_interrupt_ACK[0],microblaze_0_interrupt_ACK[1]}),
        .processor_clk(microblaze_0_Clk),
        .processor_rst(rst_clk_wiz_1_100M_mb_reset),
        .s_axi_aclk(microblaze_0_Clk),
        .s_axi_araddr(microblaze_0_intc_axi_ARADDR[8:0]),
        .s_axi_aresetn(rst_clk_wiz_1_100M_peripheral_aresetn),
        .s_axi_arready(microblaze_0_intc_axi_ARREADY),
        .s_axi_arvalid(microblaze_0_intc_axi_ARVALID),
        .s_axi_awaddr(microblaze_0_intc_axi_AWADDR[8:0]),
        .s_axi_awready(microblaze_0_intc_axi_AWREADY),
        .s_axi_awvalid(microblaze_0_intc_axi_AWVALID),
        .s_axi_bready(microblaze_0_intc_axi_BREADY),
        .s_axi_bresp(microblaze_0_intc_axi_BRESP),
        .s_axi_bvalid(microblaze_0_intc_axi_BVALID),
        .s_axi_rdata(microblaze_0_intc_axi_RDATA),
        .s_axi_rready(microblaze_0_intc_axi_RREADY),
        .s_axi_rresp(microblaze_0_intc_axi_RRESP),
        .s_axi_rvalid(microblaze_0_intc_axi_RVALID),
        .s_axi_wdata(microblaze_0_intc_axi_WDATA),
        .s_axi_wready(microblaze_0_intc_axi_WREADY),
        .s_axi_wstrb(microblaze_0_intc_axi_WSTRB),
        .s_axi_wvalid(microblaze_0_intc_axi_WVALID));
  Top_Level_Design_BD_microblaze_0_axi_periph_0 microblaze_0_axi_periph
       (.ACLK(microblaze_0_Clk),
        .ARESETN(rst_clk_wiz_1_100M_interconnect_aresetn),
        .M00_ACLK(microblaze_0_Clk),
        .M00_ARESETN(rst_clk_wiz_1_100M_peripheral_aresetn),
        .M00_AXI_araddr(microblaze_0_intc_axi_ARADDR),
        .M00_AXI_arready(microblaze_0_intc_axi_ARREADY),
        .M00_AXI_arvalid(microblaze_0_intc_axi_ARVALID),
        .M00_AXI_awaddr(microblaze_0_intc_axi_AWADDR),
        .M00_AXI_awready(microblaze_0_intc_axi_AWREADY),
        .M00_AXI_awvalid(microblaze_0_intc_axi_AWVALID),
        .M00_AXI_bready(microblaze_0_intc_axi_BREADY),
        .M00_AXI_bresp(microblaze_0_intc_axi_BRESP),
        .M00_AXI_bvalid(microblaze_0_intc_axi_BVALID),
        .M00_AXI_rdata(microblaze_0_intc_axi_RDATA),
        .M00_AXI_rready(microblaze_0_intc_axi_RREADY),
        .M00_AXI_rresp(microblaze_0_intc_axi_RRESP),
        .M00_AXI_rvalid(microblaze_0_intc_axi_RVALID),
        .M00_AXI_wdata(microblaze_0_intc_axi_WDATA),
        .M00_AXI_wready(microblaze_0_intc_axi_WREADY),
        .M00_AXI_wstrb(microblaze_0_intc_axi_WSTRB),
        .M00_AXI_wvalid(microblaze_0_intc_axi_WVALID),
        .M01_ACLK(microblaze_0_Clk),
        .M01_ARESETN(rst_clk_wiz_1_100M_peripheral_aresetn),
        .M01_AXI_araddr(microblaze_0_axi_periph_M01_AXI_ARADDR),
        .M01_AXI_arprot(microblaze_0_axi_periph_M01_AXI_ARPROT),
        .M01_AXI_arready(microblaze_0_axi_periph_M01_AXI_ARREADY),
        .M01_AXI_arvalid(microblaze_0_axi_periph_M01_AXI_ARVALID),
        .M01_AXI_awaddr(microblaze_0_axi_periph_M01_AXI_AWADDR),
        .M01_AXI_awprot(microblaze_0_axi_periph_M01_AXI_AWPROT),
        .M01_AXI_awready(microblaze_0_axi_periph_M01_AXI_AWREADY),
        .M01_AXI_awvalid(microblaze_0_axi_periph_M01_AXI_AWVALID),
        .M01_AXI_bready(microblaze_0_axi_periph_M01_AXI_BREADY),
        .M01_AXI_bresp(microblaze_0_axi_periph_M01_AXI_BRESP),
        .M01_AXI_bvalid(microblaze_0_axi_periph_M01_AXI_BVALID),
        .M01_AXI_rdata(microblaze_0_axi_periph_M01_AXI_RDATA),
        .M01_AXI_rready(microblaze_0_axi_periph_M01_AXI_RREADY),
        .M01_AXI_rresp(microblaze_0_axi_periph_M01_AXI_RRESP),
        .M01_AXI_rvalid(microblaze_0_axi_periph_M01_AXI_RVALID),
        .M01_AXI_wdata(microblaze_0_axi_periph_M01_AXI_WDATA),
        .M01_AXI_wready(microblaze_0_axi_periph_M01_AXI_WREADY),
        .M01_AXI_wstrb(microblaze_0_axi_periph_M01_AXI_WSTRB),
        .M01_AXI_wvalid(microblaze_0_axi_periph_M01_AXI_WVALID),
        .M02_ACLK(microblaze_0_Clk),
        .M02_ARESETN(rst_clk_wiz_1_100M_peripheral_aresetn),
        .M02_AXI_araddr(microblaze_0_axi_periph_M02_AXI_ARADDR),
        .M02_AXI_arprot(microblaze_0_axi_periph_M02_AXI_ARPROT),
        .M02_AXI_arready(microblaze_0_axi_periph_M02_AXI_ARREADY),
        .M02_AXI_arvalid(microblaze_0_axi_periph_M02_AXI_ARVALID),
        .M02_AXI_awaddr(microblaze_0_axi_periph_M02_AXI_AWADDR),
        .M02_AXI_awprot(microblaze_0_axi_periph_M02_AXI_AWPROT),
        .M02_AXI_awready(microblaze_0_axi_periph_M02_AXI_AWREADY),
        .M02_AXI_awvalid(microblaze_0_axi_periph_M02_AXI_AWVALID),
        .M02_AXI_bready(microblaze_0_axi_periph_M02_AXI_BREADY),
        .M02_AXI_bresp(microblaze_0_axi_periph_M02_AXI_BRESP),
        .M02_AXI_bvalid(microblaze_0_axi_periph_M02_AXI_BVALID),
        .M02_AXI_rdata(microblaze_0_axi_periph_M02_AXI_RDATA),
        .M02_AXI_rready(microblaze_0_axi_periph_M02_AXI_RREADY),
        .M02_AXI_rresp(microblaze_0_axi_periph_M02_AXI_RRESP),
        .M02_AXI_rvalid(microblaze_0_axi_periph_M02_AXI_RVALID),
        .M02_AXI_wdata(microblaze_0_axi_periph_M02_AXI_WDATA),
        .M02_AXI_wready(microblaze_0_axi_periph_M02_AXI_WREADY),
        .M02_AXI_wstrb(microblaze_0_axi_periph_M02_AXI_WSTRB),
        .M02_AXI_wvalid(microblaze_0_axi_periph_M02_AXI_WVALID),
        .M03_ACLK(microblaze_0_Clk),
        .M03_ARESETN(rst_clk_wiz_1_100M_peripheral_aresetn),
        .M03_AXI_araddr(microblaze_0_axi_periph_M03_AXI_ARADDR),
        .M03_AXI_arprot(microblaze_0_axi_periph_M03_AXI_ARPROT),
        .M03_AXI_arready(microblaze_0_axi_periph_M03_AXI_ARREADY),
        .M03_AXI_arvalid(microblaze_0_axi_periph_M03_AXI_ARVALID),
        .M03_AXI_awaddr(microblaze_0_axi_periph_M03_AXI_AWADDR),
        .M03_AXI_awprot(microblaze_0_axi_periph_M03_AXI_AWPROT),
        .M03_AXI_awready(microblaze_0_axi_periph_M03_AXI_AWREADY),
        .M03_AXI_awvalid(microblaze_0_axi_periph_M03_AXI_AWVALID),
        .M03_AXI_bready(microblaze_0_axi_periph_M03_AXI_BREADY),
        .M03_AXI_bresp(microblaze_0_axi_periph_M03_AXI_BRESP),
        .M03_AXI_bvalid(microblaze_0_axi_periph_M03_AXI_BVALID),
        .M03_AXI_rdata(microblaze_0_axi_periph_M03_AXI_RDATA),
        .M03_AXI_rready(microblaze_0_axi_periph_M03_AXI_RREADY),
        .M03_AXI_rresp(microblaze_0_axi_periph_M03_AXI_RRESP),
        .M03_AXI_rvalid(microblaze_0_axi_periph_M03_AXI_RVALID),
        .M03_AXI_wdata(microblaze_0_axi_periph_M03_AXI_WDATA),
        .M03_AXI_wready(microblaze_0_axi_periph_M03_AXI_WREADY),
        .M03_AXI_wstrb(microblaze_0_axi_periph_M03_AXI_WSTRB),
        .M03_AXI_wvalid(microblaze_0_axi_periph_M03_AXI_WVALID),
        .M04_ACLK(microblaze_0_Clk),
        .M04_ARESETN(rst_clk_wiz_1_100M_peripheral_aresetn),
        .M04_AXI_araddr(microblaze_0_axi_periph_M04_AXI_ARADDR),
        .M04_AXI_arprot(microblaze_0_axi_periph_M04_AXI_ARPROT),
        .M04_AXI_arready(microblaze_0_axi_periph_M04_AXI_ARREADY),
        .M04_AXI_arvalid(microblaze_0_axi_periph_M04_AXI_ARVALID),
        .M04_AXI_awaddr(microblaze_0_axi_periph_M04_AXI_AWADDR),
        .M04_AXI_awprot(microblaze_0_axi_periph_M04_AXI_AWPROT),
        .M04_AXI_awready(microblaze_0_axi_periph_M04_AXI_AWREADY),
        .M04_AXI_awvalid(microblaze_0_axi_periph_M04_AXI_AWVALID),
        .M04_AXI_bready(microblaze_0_axi_periph_M04_AXI_BREADY),
        .M04_AXI_bresp(microblaze_0_axi_periph_M04_AXI_BRESP),
        .M04_AXI_bvalid(microblaze_0_axi_periph_M04_AXI_BVALID),
        .M04_AXI_rdata(microblaze_0_axi_periph_M04_AXI_RDATA),
        .M04_AXI_rready(microblaze_0_axi_periph_M04_AXI_RREADY),
        .M04_AXI_rresp(microblaze_0_axi_periph_M04_AXI_RRESP),
        .M04_AXI_rvalid(microblaze_0_axi_periph_M04_AXI_RVALID),
        .M04_AXI_wdata(microblaze_0_axi_periph_M04_AXI_WDATA),
        .M04_AXI_wready(microblaze_0_axi_periph_M04_AXI_WREADY),
        .M04_AXI_wstrb(microblaze_0_axi_periph_M04_AXI_WSTRB),
        .M04_AXI_wvalid(microblaze_0_axi_periph_M04_AXI_WVALID),
        .M05_ACLK(microblaze_0_Clk),
        .M05_ARESETN(rst_clk_wiz_1_100M_peripheral_aresetn),
        .M05_AXI_araddr(microblaze_0_axi_periph_M05_AXI_ARADDR),
        .M05_AXI_arprot(microblaze_0_axi_periph_M05_AXI_ARPROT),
        .M05_AXI_arready(microblaze_0_axi_periph_M05_AXI_ARREADY),
        .M05_AXI_arvalid(microblaze_0_axi_periph_M05_AXI_ARVALID),
        .M05_AXI_awaddr(microblaze_0_axi_periph_M05_AXI_AWADDR),
        .M05_AXI_awprot(microblaze_0_axi_periph_M05_AXI_AWPROT),
        .M05_AXI_awready(microblaze_0_axi_periph_M05_AXI_AWREADY),
        .M05_AXI_awvalid(microblaze_0_axi_periph_M05_AXI_AWVALID),
        .M05_AXI_bready(microblaze_0_axi_periph_M05_AXI_BREADY),
        .M05_AXI_bresp(microblaze_0_axi_periph_M05_AXI_BRESP),
        .M05_AXI_bvalid(microblaze_0_axi_periph_M05_AXI_BVALID),
        .M05_AXI_rdata(microblaze_0_axi_periph_M05_AXI_RDATA),
        .M05_AXI_rready(microblaze_0_axi_periph_M05_AXI_RREADY),
        .M05_AXI_rresp(microblaze_0_axi_periph_M05_AXI_RRESP),
        .M05_AXI_rvalid(microblaze_0_axi_periph_M05_AXI_RVALID),
        .M05_AXI_wdata(microblaze_0_axi_periph_M05_AXI_WDATA),
        .M05_AXI_wready(microblaze_0_axi_periph_M05_AXI_WREADY),
        .M05_AXI_wstrb(microblaze_0_axi_periph_M05_AXI_WSTRB),
        .M05_AXI_wvalid(microblaze_0_axi_periph_M05_AXI_WVALID),
        .M06_ACLK(microblaze_0_Clk),
        .M06_ARESETN(rst_clk_wiz_1_100M_peripheral_aresetn),
        .M06_AXI_araddr(microblaze_0_axi_periph_M06_AXI_ARADDR),
        .M06_AXI_arready(microblaze_0_axi_periph_M06_AXI_ARREADY),
        .M06_AXI_arvalid(microblaze_0_axi_periph_M06_AXI_ARVALID),
        .M06_AXI_awaddr(microblaze_0_axi_periph_M06_AXI_AWADDR),
        .M06_AXI_awready(microblaze_0_axi_periph_M06_AXI_AWREADY),
        .M06_AXI_awvalid(microblaze_0_axi_periph_M06_AXI_AWVALID),
        .M06_AXI_bready(microblaze_0_axi_periph_M06_AXI_BREADY),
        .M06_AXI_bresp(microblaze_0_axi_periph_M06_AXI_BRESP),
        .M06_AXI_bvalid(microblaze_0_axi_periph_M06_AXI_BVALID),
        .M06_AXI_rdata(microblaze_0_axi_periph_M06_AXI_RDATA),
        .M06_AXI_rready(microblaze_0_axi_periph_M06_AXI_RREADY),
        .M06_AXI_rresp(microblaze_0_axi_periph_M06_AXI_RRESP),
        .M06_AXI_rvalid(microblaze_0_axi_periph_M06_AXI_RVALID),
        .M06_AXI_wdata(microblaze_0_axi_periph_M06_AXI_WDATA),
        .M06_AXI_wready(microblaze_0_axi_periph_M06_AXI_WREADY),
        .M06_AXI_wstrb(microblaze_0_axi_periph_M06_AXI_WSTRB),
        .M06_AXI_wvalid(microblaze_0_axi_periph_M06_AXI_WVALID),
        .M07_ACLK(microblaze_0_Clk),
        .M07_ARESETN(rst_clk_wiz_1_100M_peripheral_aresetn),
        .M07_AXI_araddr(microblaze_0_axi_periph_M07_AXI_ARADDR),
        .M07_AXI_arready(microblaze_0_axi_periph_M07_AXI_ARREADY),
        .M07_AXI_arvalid(microblaze_0_axi_periph_M07_AXI_ARVALID),
        .M07_AXI_awaddr(microblaze_0_axi_periph_M07_AXI_AWADDR),
        .M07_AXI_awready(microblaze_0_axi_periph_M07_AXI_AWREADY),
        .M07_AXI_awvalid(microblaze_0_axi_periph_M07_AXI_AWVALID),
        .M07_AXI_bready(microblaze_0_axi_periph_M07_AXI_BREADY),
        .M07_AXI_bresp(microblaze_0_axi_periph_M07_AXI_BRESP),
        .M07_AXI_bvalid(microblaze_0_axi_periph_M07_AXI_BVALID),
        .M07_AXI_rdata(microblaze_0_axi_periph_M07_AXI_RDATA),
        .M07_AXI_rready(microblaze_0_axi_periph_M07_AXI_RREADY),
        .M07_AXI_rresp(microblaze_0_axi_periph_M07_AXI_RRESP),
        .M07_AXI_rvalid(microblaze_0_axi_periph_M07_AXI_RVALID),
        .M07_AXI_wdata(microblaze_0_axi_periph_M07_AXI_WDATA),
        .M07_AXI_wready(microblaze_0_axi_periph_M07_AXI_WREADY),
        .M07_AXI_wstrb(microblaze_0_axi_periph_M07_AXI_WSTRB),
        .M07_AXI_wvalid(microblaze_0_axi_periph_M07_AXI_WVALID),
        .S00_ACLK(microblaze_0_Clk),
        .S00_ARESETN(rst_clk_wiz_1_100M_peripheral_aresetn),
        .S00_AXI_araddr(microblaze_0_axi_dp_ARADDR),
        .S00_AXI_arprot(microblaze_0_axi_dp_ARPROT),
        .S00_AXI_arready(microblaze_0_axi_dp_ARREADY),
        .S00_AXI_arvalid(microblaze_0_axi_dp_ARVALID),
        .S00_AXI_awaddr(microblaze_0_axi_dp_AWADDR),
        .S00_AXI_awprot(microblaze_0_axi_dp_AWPROT),
        .S00_AXI_awready(microblaze_0_axi_dp_AWREADY),
        .S00_AXI_awvalid(microblaze_0_axi_dp_AWVALID),
        .S00_AXI_bready(microblaze_0_axi_dp_BREADY),
        .S00_AXI_bresp(microblaze_0_axi_dp_BRESP),
        .S00_AXI_bvalid(microblaze_0_axi_dp_BVALID),
        .S00_AXI_rdata(microblaze_0_axi_dp_RDATA),
        .S00_AXI_rready(microblaze_0_axi_dp_RREADY),
        .S00_AXI_rresp(microblaze_0_axi_dp_RRESP),
        .S00_AXI_rvalid(microblaze_0_axi_dp_RVALID),
        .S00_AXI_wdata(microblaze_0_axi_dp_WDATA),
        .S00_AXI_wready(microblaze_0_axi_dp_WREADY),
        .S00_AXI_wstrb(microblaze_0_axi_dp_WSTRB),
        .S00_AXI_wvalid(microblaze_0_axi_dp_WVALID));
  microblaze_0_local_memory_imp_M557DB microblaze_0_local_memory
       (.DLMB_abus(microblaze_0_dlmb_1_ABUS),
        .DLMB_addrstrobe(microblaze_0_dlmb_1_ADDRSTROBE),
        .DLMB_be(microblaze_0_dlmb_1_BE),
        .DLMB_ce(microblaze_0_dlmb_1_CE),
        .DLMB_readdbus(microblaze_0_dlmb_1_READDBUS),
        .DLMB_readstrobe(microblaze_0_dlmb_1_READSTROBE),
        .DLMB_ready(microblaze_0_dlmb_1_READY),
        .DLMB_ue(microblaze_0_dlmb_1_UE),
        .DLMB_wait(microblaze_0_dlmb_1_WAIT),
        .DLMB_writedbus(microblaze_0_dlmb_1_WRITEDBUS),
        .DLMB_writestrobe(microblaze_0_dlmb_1_WRITESTROBE),
        .ILMB_abus(microblaze_0_ilmb_1_ABUS),
        .ILMB_addrstrobe(microblaze_0_ilmb_1_ADDRSTROBE),
        .ILMB_ce(microblaze_0_ilmb_1_CE),
        .ILMB_readdbus(microblaze_0_ilmb_1_READDBUS),
        .ILMB_readstrobe(microblaze_0_ilmb_1_READSTROBE),
        .ILMB_ready(microblaze_0_ilmb_1_READY),
        .ILMB_ue(microblaze_0_ilmb_1_UE),
        .ILMB_wait(microblaze_0_ilmb_1_WAIT),
        .LMB_Clk(microblaze_0_Clk),
        .SYS_Rst(rst_clk_wiz_1_100M_bus_struct_reset));
  Top_Level_Design_BD_microblaze_0_xlconcat_0 microblaze_0_xlconcat
       (.In0(axi_uartlite_0_interrupt),
        .In1(axi_uartlite_1_interrupt),
        .dout(microblaze_0_intr));
  Top_Level_Design_BD_rst_clk_wiz_1_100M_0 rst_clk_wiz_1_100M
       (.aux_reset_in(1'b1),
        .bus_struct_reset(rst_clk_wiz_1_100M_bus_struct_reset),
        .dcm_locked(clk_wiz_1_locked),
        .ext_reset_in(reset_rtl_0_1),
        .interconnect_aresetn(rst_clk_wiz_1_100M_interconnect_aresetn),
        .mb_debug_sys_rst(mdm_1_debug_sys_rst),
        .mb_reset(rst_clk_wiz_1_100M_mb_reset),
        .peripheral_aresetn(rst_clk_wiz_1_100M_peripheral_aresetn),
        .slowest_sync_clk(microblaze_0_Clk));
endmodule

module Top_Level_Design_BD_microblaze_0_axi_periph_0
   (ACLK,
    ARESETN,
    M00_ACLK,
    M00_ARESETN,
    M00_AXI_araddr,
    M00_AXI_arready,
    M00_AXI_arvalid,
    M00_AXI_awaddr,
    M00_AXI_awready,
    M00_AXI_awvalid,
    M00_AXI_bready,
    M00_AXI_bresp,
    M00_AXI_bvalid,
    M00_AXI_rdata,
    M00_AXI_rready,
    M00_AXI_rresp,
    M00_AXI_rvalid,
    M00_AXI_wdata,
    M00_AXI_wready,
    M00_AXI_wstrb,
    M00_AXI_wvalid,
    M01_ACLK,
    M01_ARESETN,
    M01_AXI_araddr,
    M01_AXI_arprot,
    M01_AXI_arready,
    M01_AXI_arvalid,
    M01_AXI_awaddr,
    M01_AXI_awprot,
    M01_AXI_awready,
    M01_AXI_awvalid,
    M01_AXI_bready,
    M01_AXI_bresp,
    M01_AXI_bvalid,
    M01_AXI_rdata,
    M01_AXI_rready,
    M01_AXI_rresp,
    M01_AXI_rvalid,
    M01_AXI_wdata,
    M01_AXI_wready,
    M01_AXI_wstrb,
    M01_AXI_wvalid,
    M02_ACLK,
    M02_ARESETN,
    M02_AXI_araddr,
    M02_AXI_arprot,
    M02_AXI_arready,
    M02_AXI_arvalid,
    M02_AXI_awaddr,
    M02_AXI_awprot,
    M02_AXI_awready,
    M02_AXI_awvalid,
    M02_AXI_bready,
    M02_AXI_bresp,
    M02_AXI_bvalid,
    M02_AXI_rdata,
    M02_AXI_rready,
    M02_AXI_rresp,
    M02_AXI_rvalid,
    M02_AXI_wdata,
    M02_AXI_wready,
    M02_AXI_wstrb,
    M02_AXI_wvalid,
    M03_ACLK,
    M03_ARESETN,
    M03_AXI_araddr,
    M03_AXI_arprot,
    M03_AXI_arready,
    M03_AXI_arvalid,
    M03_AXI_awaddr,
    M03_AXI_awprot,
    M03_AXI_awready,
    M03_AXI_awvalid,
    M03_AXI_bready,
    M03_AXI_bresp,
    M03_AXI_bvalid,
    M03_AXI_rdata,
    M03_AXI_rready,
    M03_AXI_rresp,
    M03_AXI_rvalid,
    M03_AXI_wdata,
    M03_AXI_wready,
    M03_AXI_wstrb,
    M03_AXI_wvalid,
    M04_ACLK,
    M04_ARESETN,
    M04_AXI_araddr,
    M04_AXI_arprot,
    M04_AXI_arready,
    M04_AXI_arvalid,
    M04_AXI_awaddr,
    M04_AXI_awprot,
    M04_AXI_awready,
    M04_AXI_awvalid,
    M04_AXI_bready,
    M04_AXI_bresp,
    M04_AXI_bvalid,
    M04_AXI_rdata,
    M04_AXI_rready,
    M04_AXI_rresp,
    M04_AXI_rvalid,
    M04_AXI_wdata,
    M04_AXI_wready,
    M04_AXI_wstrb,
    M04_AXI_wvalid,
    M05_ACLK,
    M05_ARESETN,
    M05_AXI_araddr,
    M05_AXI_arprot,
    M05_AXI_arready,
    M05_AXI_arvalid,
    M05_AXI_awaddr,
    M05_AXI_awprot,
    M05_AXI_awready,
    M05_AXI_awvalid,
    M05_AXI_bready,
    M05_AXI_bresp,
    M05_AXI_bvalid,
    M05_AXI_rdata,
    M05_AXI_rready,
    M05_AXI_rresp,
    M05_AXI_rvalid,
    M05_AXI_wdata,
    M05_AXI_wready,
    M05_AXI_wstrb,
    M05_AXI_wvalid,
    M06_ACLK,
    M06_ARESETN,
    M06_AXI_araddr,
    M06_AXI_arready,
    M06_AXI_arvalid,
    M06_AXI_awaddr,
    M06_AXI_awready,
    M06_AXI_awvalid,
    M06_AXI_bready,
    M06_AXI_bresp,
    M06_AXI_bvalid,
    M06_AXI_rdata,
    M06_AXI_rready,
    M06_AXI_rresp,
    M06_AXI_rvalid,
    M06_AXI_wdata,
    M06_AXI_wready,
    M06_AXI_wstrb,
    M06_AXI_wvalid,
    M07_ACLK,
    M07_ARESETN,
    M07_AXI_araddr,
    M07_AXI_arready,
    M07_AXI_arvalid,
    M07_AXI_awaddr,
    M07_AXI_awready,
    M07_AXI_awvalid,
    M07_AXI_bready,
    M07_AXI_bresp,
    M07_AXI_bvalid,
    M07_AXI_rdata,
    M07_AXI_rready,
    M07_AXI_rresp,
    M07_AXI_rvalid,
    M07_AXI_wdata,
    M07_AXI_wready,
    M07_AXI_wstrb,
    M07_AXI_wvalid,
    S00_ACLK,
    S00_ARESETN,
    S00_AXI_araddr,
    S00_AXI_arprot,
    S00_AXI_arready,
    S00_AXI_arvalid,
    S00_AXI_awaddr,
    S00_AXI_awprot,
    S00_AXI_awready,
    S00_AXI_awvalid,
    S00_AXI_bready,
    S00_AXI_bresp,
    S00_AXI_bvalid,
    S00_AXI_rdata,
    S00_AXI_rready,
    S00_AXI_rresp,
    S00_AXI_rvalid,
    S00_AXI_wdata,
    S00_AXI_wready,
    S00_AXI_wstrb,
    S00_AXI_wvalid);
  input ACLK;
  input [0:0]ARESETN;
  input M00_ACLK;
  input [0:0]M00_ARESETN;
  output [31:0]M00_AXI_araddr;
  input M00_AXI_arready;
  output M00_AXI_arvalid;
  output [31:0]M00_AXI_awaddr;
  input M00_AXI_awready;
  output M00_AXI_awvalid;
  output M00_AXI_bready;
  input [1:0]M00_AXI_bresp;
  input M00_AXI_bvalid;
  input [31:0]M00_AXI_rdata;
  output M00_AXI_rready;
  input [1:0]M00_AXI_rresp;
  input M00_AXI_rvalid;
  output [31:0]M00_AXI_wdata;
  input M00_AXI_wready;
  output [3:0]M00_AXI_wstrb;
  output M00_AXI_wvalid;
  input M01_ACLK;
  input [0:0]M01_ARESETN;
  output [31:0]M01_AXI_araddr;
  output [2:0]M01_AXI_arprot;
  input M01_AXI_arready;
  output M01_AXI_arvalid;
  output [31:0]M01_AXI_awaddr;
  output [2:0]M01_AXI_awprot;
  input M01_AXI_awready;
  output M01_AXI_awvalid;
  output M01_AXI_bready;
  input [1:0]M01_AXI_bresp;
  input M01_AXI_bvalid;
  input [31:0]M01_AXI_rdata;
  output M01_AXI_rready;
  input [1:0]M01_AXI_rresp;
  input M01_AXI_rvalid;
  output [31:0]M01_AXI_wdata;
  input M01_AXI_wready;
  output [3:0]M01_AXI_wstrb;
  output M01_AXI_wvalid;
  input M02_ACLK;
  input [0:0]M02_ARESETN;
  output [31:0]M02_AXI_araddr;
  output [2:0]M02_AXI_arprot;
  input M02_AXI_arready;
  output M02_AXI_arvalid;
  output [31:0]M02_AXI_awaddr;
  output [2:0]M02_AXI_awprot;
  input M02_AXI_awready;
  output M02_AXI_awvalid;
  output M02_AXI_bready;
  input [1:0]M02_AXI_bresp;
  input M02_AXI_bvalid;
  input [31:0]M02_AXI_rdata;
  output M02_AXI_rready;
  input [1:0]M02_AXI_rresp;
  input M02_AXI_rvalid;
  output [31:0]M02_AXI_wdata;
  input M02_AXI_wready;
  output [3:0]M02_AXI_wstrb;
  output M02_AXI_wvalid;
  input M03_ACLK;
  input [0:0]M03_ARESETN;
  output [31:0]M03_AXI_araddr;
  output [2:0]M03_AXI_arprot;
  input M03_AXI_arready;
  output M03_AXI_arvalid;
  output [31:0]M03_AXI_awaddr;
  output [2:0]M03_AXI_awprot;
  input M03_AXI_awready;
  output M03_AXI_awvalid;
  output M03_AXI_bready;
  input [1:0]M03_AXI_bresp;
  input M03_AXI_bvalid;
  input [31:0]M03_AXI_rdata;
  output M03_AXI_rready;
  input [1:0]M03_AXI_rresp;
  input M03_AXI_rvalid;
  output [31:0]M03_AXI_wdata;
  input M03_AXI_wready;
  output [3:0]M03_AXI_wstrb;
  output M03_AXI_wvalid;
  input M04_ACLK;
  input [0:0]M04_ARESETN;
  output [31:0]M04_AXI_araddr;
  output [2:0]M04_AXI_arprot;
  input M04_AXI_arready;
  output M04_AXI_arvalid;
  output [31:0]M04_AXI_awaddr;
  output [2:0]M04_AXI_awprot;
  input M04_AXI_awready;
  output M04_AXI_awvalid;
  output M04_AXI_bready;
  input [1:0]M04_AXI_bresp;
  input M04_AXI_bvalid;
  input [31:0]M04_AXI_rdata;
  output M04_AXI_rready;
  input [1:0]M04_AXI_rresp;
  input M04_AXI_rvalid;
  output [31:0]M04_AXI_wdata;
  input M04_AXI_wready;
  output [3:0]M04_AXI_wstrb;
  output M04_AXI_wvalid;
  input M05_ACLK;
  input [0:0]M05_ARESETN;
  output [31:0]M05_AXI_araddr;
  output [2:0]M05_AXI_arprot;
  input M05_AXI_arready;
  output M05_AXI_arvalid;
  output [31:0]M05_AXI_awaddr;
  output [2:0]M05_AXI_awprot;
  input M05_AXI_awready;
  output M05_AXI_awvalid;
  output M05_AXI_bready;
  input [1:0]M05_AXI_bresp;
  input M05_AXI_bvalid;
  input [31:0]M05_AXI_rdata;
  output M05_AXI_rready;
  input [1:0]M05_AXI_rresp;
  input M05_AXI_rvalid;
  output [31:0]M05_AXI_wdata;
  input M05_AXI_wready;
  output [3:0]M05_AXI_wstrb;
  output M05_AXI_wvalid;
  input M06_ACLK;
  input [0:0]M06_ARESETN;
  output [31:0]M06_AXI_araddr;
  input M06_AXI_arready;
  output M06_AXI_arvalid;
  output [31:0]M06_AXI_awaddr;
  input M06_AXI_awready;
  output M06_AXI_awvalid;
  output M06_AXI_bready;
  input [1:0]M06_AXI_bresp;
  input M06_AXI_bvalid;
  input [31:0]M06_AXI_rdata;
  output M06_AXI_rready;
  input [1:0]M06_AXI_rresp;
  input M06_AXI_rvalid;
  output [31:0]M06_AXI_wdata;
  input M06_AXI_wready;
  output [3:0]M06_AXI_wstrb;
  output M06_AXI_wvalid;
  input M07_ACLK;
  input [0:0]M07_ARESETN;
  output [31:0]M07_AXI_araddr;
  input M07_AXI_arready;
  output M07_AXI_arvalid;
  output [31:0]M07_AXI_awaddr;
  input M07_AXI_awready;
  output M07_AXI_awvalid;
  output M07_AXI_bready;
  input [1:0]M07_AXI_bresp;
  input M07_AXI_bvalid;
  input [31:0]M07_AXI_rdata;
  output M07_AXI_rready;
  input [1:0]M07_AXI_rresp;
  input M07_AXI_rvalid;
  output [31:0]M07_AXI_wdata;
  input M07_AXI_wready;
  output [3:0]M07_AXI_wstrb;
  output M07_AXI_wvalid;
  input S00_ACLK;
  input [0:0]S00_ARESETN;
  input [31:0]S00_AXI_araddr;
  input [2:0]S00_AXI_arprot;
  output [0:0]S00_AXI_arready;
  input [0:0]S00_AXI_arvalid;
  input [31:0]S00_AXI_awaddr;
  input [2:0]S00_AXI_awprot;
  output [0:0]S00_AXI_awready;
  input [0:0]S00_AXI_awvalid;
  input [0:0]S00_AXI_bready;
  output [1:0]S00_AXI_bresp;
  output [0:0]S00_AXI_bvalid;
  output [31:0]S00_AXI_rdata;
  input [0:0]S00_AXI_rready;
  output [1:0]S00_AXI_rresp;
  output [0:0]S00_AXI_rvalid;
  input [31:0]S00_AXI_wdata;
  output [0:0]S00_AXI_wready;
  input [3:0]S00_AXI_wstrb;
  input [0:0]S00_AXI_wvalid;

  wire M00_ACLK_1;
  wire [0:0]M00_ARESETN_1;
  wire M01_ACLK_1;
  wire [0:0]M01_ARESETN_1;
  wire M02_ACLK_1;
  wire [0:0]M02_ARESETN_1;
  wire M03_ACLK_1;
  wire [0:0]M03_ARESETN_1;
  wire M04_ACLK_1;
  wire [0:0]M04_ARESETN_1;
  wire M05_ACLK_1;
  wire [0:0]M05_ARESETN_1;
  wire M06_ACLK_1;
  wire [0:0]M06_ARESETN_1;
  wire M07_ACLK_1;
  wire [0:0]M07_ARESETN_1;
  wire S00_ACLK_1;
  wire [0:0]S00_ARESETN_1;
  wire [31:0]m00_couplers_to_microblaze_0_axi_periph_ARADDR;
  wire m00_couplers_to_microblaze_0_axi_periph_ARREADY;
  wire m00_couplers_to_microblaze_0_axi_periph_ARVALID;
  wire [31:0]m00_couplers_to_microblaze_0_axi_periph_AWADDR;
  wire m00_couplers_to_microblaze_0_axi_periph_AWREADY;
  wire m00_couplers_to_microblaze_0_axi_periph_AWVALID;
  wire m00_couplers_to_microblaze_0_axi_periph_BREADY;
  wire [1:0]m00_couplers_to_microblaze_0_axi_periph_BRESP;
  wire m00_couplers_to_microblaze_0_axi_periph_BVALID;
  wire [31:0]m00_couplers_to_microblaze_0_axi_periph_RDATA;
  wire m00_couplers_to_microblaze_0_axi_periph_RREADY;
  wire [1:0]m00_couplers_to_microblaze_0_axi_periph_RRESP;
  wire m00_couplers_to_microblaze_0_axi_periph_RVALID;
  wire [31:0]m00_couplers_to_microblaze_0_axi_periph_WDATA;
  wire m00_couplers_to_microblaze_0_axi_periph_WREADY;
  wire [3:0]m00_couplers_to_microblaze_0_axi_periph_WSTRB;
  wire m00_couplers_to_microblaze_0_axi_periph_WVALID;
  wire [31:0]m01_couplers_to_microblaze_0_axi_periph_ARADDR;
  wire [2:0]m01_couplers_to_microblaze_0_axi_periph_ARPROT;
  wire m01_couplers_to_microblaze_0_axi_periph_ARREADY;
  wire m01_couplers_to_microblaze_0_axi_periph_ARVALID;
  wire [31:0]m01_couplers_to_microblaze_0_axi_periph_AWADDR;
  wire [2:0]m01_couplers_to_microblaze_0_axi_periph_AWPROT;
  wire m01_couplers_to_microblaze_0_axi_periph_AWREADY;
  wire m01_couplers_to_microblaze_0_axi_periph_AWVALID;
  wire m01_couplers_to_microblaze_0_axi_periph_BREADY;
  wire [1:0]m01_couplers_to_microblaze_0_axi_periph_BRESP;
  wire m01_couplers_to_microblaze_0_axi_periph_BVALID;
  wire [31:0]m01_couplers_to_microblaze_0_axi_periph_RDATA;
  wire m01_couplers_to_microblaze_0_axi_periph_RREADY;
  wire [1:0]m01_couplers_to_microblaze_0_axi_periph_RRESP;
  wire m01_couplers_to_microblaze_0_axi_periph_RVALID;
  wire [31:0]m01_couplers_to_microblaze_0_axi_periph_WDATA;
  wire m01_couplers_to_microblaze_0_axi_periph_WREADY;
  wire [3:0]m01_couplers_to_microblaze_0_axi_periph_WSTRB;
  wire m01_couplers_to_microblaze_0_axi_periph_WVALID;
  wire [31:0]m02_couplers_to_microblaze_0_axi_periph_ARADDR;
  wire [2:0]m02_couplers_to_microblaze_0_axi_periph_ARPROT;
  wire m02_couplers_to_microblaze_0_axi_periph_ARREADY;
  wire m02_couplers_to_microblaze_0_axi_periph_ARVALID;
  wire [31:0]m02_couplers_to_microblaze_0_axi_periph_AWADDR;
  wire [2:0]m02_couplers_to_microblaze_0_axi_periph_AWPROT;
  wire m02_couplers_to_microblaze_0_axi_periph_AWREADY;
  wire m02_couplers_to_microblaze_0_axi_periph_AWVALID;
  wire m02_couplers_to_microblaze_0_axi_periph_BREADY;
  wire [1:0]m02_couplers_to_microblaze_0_axi_periph_BRESP;
  wire m02_couplers_to_microblaze_0_axi_periph_BVALID;
  wire [31:0]m02_couplers_to_microblaze_0_axi_periph_RDATA;
  wire m02_couplers_to_microblaze_0_axi_periph_RREADY;
  wire [1:0]m02_couplers_to_microblaze_0_axi_periph_RRESP;
  wire m02_couplers_to_microblaze_0_axi_periph_RVALID;
  wire [31:0]m02_couplers_to_microblaze_0_axi_periph_WDATA;
  wire m02_couplers_to_microblaze_0_axi_periph_WREADY;
  wire [3:0]m02_couplers_to_microblaze_0_axi_periph_WSTRB;
  wire m02_couplers_to_microblaze_0_axi_periph_WVALID;
  wire [31:0]m03_couplers_to_microblaze_0_axi_periph_ARADDR;
  wire [2:0]m03_couplers_to_microblaze_0_axi_periph_ARPROT;
  wire m03_couplers_to_microblaze_0_axi_periph_ARREADY;
  wire m03_couplers_to_microblaze_0_axi_periph_ARVALID;
  wire [31:0]m03_couplers_to_microblaze_0_axi_periph_AWADDR;
  wire [2:0]m03_couplers_to_microblaze_0_axi_periph_AWPROT;
  wire m03_couplers_to_microblaze_0_axi_periph_AWREADY;
  wire m03_couplers_to_microblaze_0_axi_periph_AWVALID;
  wire m03_couplers_to_microblaze_0_axi_periph_BREADY;
  wire [1:0]m03_couplers_to_microblaze_0_axi_periph_BRESP;
  wire m03_couplers_to_microblaze_0_axi_periph_BVALID;
  wire [31:0]m03_couplers_to_microblaze_0_axi_periph_RDATA;
  wire m03_couplers_to_microblaze_0_axi_periph_RREADY;
  wire [1:0]m03_couplers_to_microblaze_0_axi_periph_RRESP;
  wire m03_couplers_to_microblaze_0_axi_periph_RVALID;
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
  wire m07_couplers_to_microblaze_0_axi_periph_WREADY;
  wire [3:0]m07_couplers_to_microblaze_0_axi_periph_WSTRB;
  wire m07_couplers_to_microblaze_0_axi_periph_WVALID;
  wire microblaze_0_axi_periph_ACLK_net;
  wire [0:0]microblaze_0_axi_periph_ARESETN_net;
  wire [31:0]microblaze_0_axi_periph_to_s00_couplers_ARADDR;
  wire [2:0]microblaze_0_axi_periph_to_s00_couplers_ARPROT;
  wire [0:0]microblaze_0_axi_periph_to_s00_couplers_ARREADY;
  wire [0:0]microblaze_0_axi_periph_to_s00_couplers_ARVALID;
  wire [31:0]microblaze_0_axi_periph_to_s00_couplers_AWADDR;
  wire [2:0]microblaze_0_axi_periph_to_s00_couplers_AWPROT;
  wire [0:0]microblaze_0_axi_periph_to_s00_couplers_AWREADY;
  wire [0:0]microblaze_0_axi_periph_to_s00_couplers_AWVALID;
  wire [0:0]microblaze_0_axi_periph_to_s00_couplers_BREADY;
  wire [1:0]microblaze_0_axi_periph_to_s00_couplers_BRESP;
  wire [0:0]microblaze_0_axi_periph_to_s00_couplers_BVALID;
  wire [31:0]microblaze_0_axi_periph_to_s00_couplers_RDATA;
  wire [0:0]microblaze_0_axi_periph_to_s00_couplers_RREADY;
  wire [1:0]microblaze_0_axi_periph_to_s00_couplers_RRESP;
  wire [0:0]microblaze_0_axi_periph_to_s00_couplers_RVALID;
  wire [31:0]microblaze_0_axi_periph_to_s00_couplers_WDATA;
  wire [0:0]microblaze_0_axi_periph_to_s00_couplers_WREADY;
  wire [3:0]microblaze_0_axi_periph_to_s00_couplers_WSTRB;
  wire [0:0]microblaze_0_axi_periph_to_s00_couplers_WVALID;
  wire [31:0]s00_couplers_to_xbar_ARADDR;
  wire [2:0]s00_couplers_to_xbar_ARPROT;
  wire [0:0]s00_couplers_to_xbar_ARREADY;
  wire [0:0]s00_couplers_to_xbar_ARVALID;
  wire [31:0]s00_couplers_to_xbar_AWADDR;
  wire [2:0]s00_couplers_to_xbar_AWPROT;
  wire [0:0]s00_couplers_to_xbar_AWREADY;
  wire [0:0]s00_couplers_to_xbar_AWVALID;
  wire [0:0]s00_couplers_to_xbar_BREADY;
  wire [1:0]s00_couplers_to_xbar_BRESP;
  wire [0:0]s00_couplers_to_xbar_BVALID;
  wire [31:0]s00_couplers_to_xbar_RDATA;
  wire [0:0]s00_couplers_to_xbar_RREADY;
  wire [1:0]s00_couplers_to_xbar_RRESP;
  wire [0:0]s00_couplers_to_xbar_RVALID;
  wire [31:0]s00_couplers_to_xbar_WDATA;
  wire [0:0]s00_couplers_to_xbar_WREADY;
  wire [3:0]s00_couplers_to_xbar_WSTRB;
  wire [0:0]s00_couplers_to_xbar_WVALID;
  wire [31:0]xbar_to_m00_couplers_ARADDR;
  wire xbar_to_m00_couplers_ARREADY;
  wire [0:0]xbar_to_m00_couplers_ARVALID;
  wire [31:0]xbar_to_m00_couplers_AWADDR;
  wire xbar_to_m00_couplers_AWREADY;
  wire [0:0]xbar_to_m00_couplers_AWVALID;
  wire [0:0]xbar_to_m00_couplers_BREADY;
  wire [1:0]xbar_to_m00_couplers_BRESP;
  wire xbar_to_m00_couplers_BVALID;
  wire [31:0]xbar_to_m00_couplers_RDATA;
  wire [0:0]xbar_to_m00_couplers_RREADY;
  wire [1:0]xbar_to_m00_couplers_RRESP;
  wire xbar_to_m00_couplers_RVALID;
  wire [31:0]xbar_to_m00_couplers_WDATA;
  wire xbar_to_m00_couplers_WREADY;
  wire [3:0]xbar_to_m00_couplers_WSTRB;
  wire [0:0]xbar_to_m00_couplers_WVALID;
  wire [63:32]xbar_to_m01_couplers_ARADDR;
  wire [5:3]xbar_to_m01_couplers_ARPROT;
  wire xbar_to_m01_couplers_ARREADY;
  wire [1:1]xbar_to_m01_couplers_ARVALID;
  wire [63:32]xbar_to_m01_couplers_AWADDR;
  wire [5:3]xbar_to_m01_couplers_AWPROT;
  wire xbar_to_m01_couplers_AWREADY;
  wire [1:1]xbar_to_m01_couplers_AWVALID;
  wire [1:1]xbar_to_m01_couplers_BREADY;
  wire [1:0]xbar_to_m01_couplers_BRESP;
  wire xbar_to_m01_couplers_BVALID;
  wire [31:0]xbar_to_m01_couplers_RDATA;
  wire [1:1]xbar_to_m01_couplers_RREADY;
  wire [1:0]xbar_to_m01_couplers_RRESP;
  wire xbar_to_m01_couplers_RVALID;
  wire [63:32]xbar_to_m01_couplers_WDATA;
  wire xbar_to_m01_couplers_WREADY;
  wire [7:4]xbar_to_m01_couplers_WSTRB;
  wire [1:1]xbar_to_m01_couplers_WVALID;
  wire [95:64]xbar_to_m02_couplers_ARADDR;
  wire [8:6]xbar_to_m02_couplers_ARPROT;
  wire xbar_to_m02_couplers_ARREADY;
  wire [2:2]xbar_to_m02_couplers_ARVALID;
  wire [95:64]xbar_to_m02_couplers_AWADDR;
  wire [8:6]xbar_to_m02_couplers_AWPROT;
  wire xbar_to_m02_couplers_AWREADY;
  wire [2:2]xbar_to_m02_couplers_AWVALID;
  wire [2:2]xbar_to_m02_couplers_BREADY;
  wire [1:0]xbar_to_m02_couplers_BRESP;
  wire xbar_to_m02_couplers_BVALID;
  wire [31:0]xbar_to_m02_couplers_RDATA;
  wire [2:2]xbar_to_m02_couplers_RREADY;
  wire [1:0]xbar_to_m02_couplers_RRESP;
  wire xbar_to_m02_couplers_RVALID;
  wire [95:64]xbar_to_m02_couplers_WDATA;
  wire xbar_to_m02_couplers_WREADY;
  wire [11:8]xbar_to_m02_couplers_WSTRB;
  wire [2:2]xbar_to_m02_couplers_WVALID;
  wire [127:96]xbar_to_m03_couplers_ARADDR;
  wire [11:9]xbar_to_m03_couplers_ARPROT;
  wire xbar_to_m03_couplers_ARREADY;
  wire [3:3]xbar_to_m03_couplers_ARVALID;
  wire [127:96]xbar_to_m03_couplers_AWADDR;
  wire [11:9]xbar_to_m03_couplers_AWPROT;
  wire xbar_to_m03_couplers_AWREADY;
  wire [3:3]xbar_to_m03_couplers_AWVALID;
  wire [3:3]xbar_to_m03_couplers_BREADY;
  wire [1:0]xbar_to_m03_couplers_BRESP;
  wire xbar_to_m03_couplers_BVALID;
  wire [31:0]xbar_to_m03_couplers_RDATA;
  wire [3:3]xbar_to_m03_couplers_RREADY;
  wire [1:0]xbar_to_m03_couplers_RRESP;
  wire xbar_to_m03_couplers_RVALID;
  wire [127:96]xbar_to_m03_couplers_WDATA;
  wire xbar_to_m03_couplers_WREADY;
  wire [15:12]xbar_to_m03_couplers_WSTRB;
  wire [3:3]xbar_to_m03_couplers_WVALID;
  wire [159:128]xbar_to_m04_couplers_ARADDR;
  wire [14:12]xbar_to_m04_couplers_ARPROT;
  wire xbar_to_m04_couplers_ARREADY;
  wire [4:4]xbar_to_m04_couplers_ARVALID;
  wire [159:128]xbar_to_m04_couplers_AWADDR;
  wire [14:12]xbar_to_m04_couplers_AWPROT;
  wire xbar_to_m04_couplers_AWREADY;
  wire [4:4]xbar_to_m04_couplers_AWVALID;
  wire [4:4]xbar_to_m04_couplers_BREADY;
  wire [1:0]xbar_to_m04_couplers_BRESP;
  wire xbar_to_m04_couplers_BVALID;
  wire [31:0]xbar_to_m04_couplers_RDATA;
  wire [4:4]xbar_to_m04_couplers_RREADY;
  wire [1:0]xbar_to_m04_couplers_RRESP;
  wire xbar_to_m04_couplers_RVALID;
  wire [159:128]xbar_to_m04_couplers_WDATA;
  wire xbar_to_m04_couplers_WREADY;
  wire [19:16]xbar_to_m04_couplers_WSTRB;
  wire [4:4]xbar_to_m04_couplers_WVALID;
  wire [191:160]xbar_to_m05_couplers_ARADDR;
  wire [17:15]xbar_to_m05_couplers_ARPROT;
  wire xbar_to_m05_couplers_ARREADY;
  wire [5:5]xbar_to_m05_couplers_ARVALID;
  wire [191:160]xbar_to_m05_couplers_AWADDR;
  wire [17:15]xbar_to_m05_couplers_AWPROT;
  wire xbar_to_m05_couplers_AWREADY;
  wire [5:5]xbar_to_m05_couplers_AWVALID;
  wire [5:5]xbar_to_m05_couplers_BREADY;
  wire [1:0]xbar_to_m05_couplers_BRESP;
  wire xbar_to_m05_couplers_BVALID;
  wire [31:0]xbar_to_m05_couplers_RDATA;
  wire [5:5]xbar_to_m05_couplers_RREADY;
  wire [1:0]xbar_to_m05_couplers_RRESP;
  wire xbar_to_m05_couplers_RVALID;
  wire [191:160]xbar_to_m05_couplers_WDATA;
  wire xbar_to_m05_couplers_WREADY;
  wire [23:20]xbar_to_m05_couplers_WSTRB;
  wire [5:5]xbar_to_m05_couplers_WVALID;
  wire [223:192]xbar_to_m06_couplers_ARADDR;
  wire xbar_to_m06_couplers_ARREADY;
  wire [6:6]xbar_to_m06_couplers_ARVALID;
  wire [223:192]xbar_to_m06_couplers_AWADDR;
  wire xbar_to_m06_couplers_AWREADY;
  wire [6:6]xbar_to_m06_couplers_AWVALID;
  wire [6:6]xbar_to_m06_couplers_BREADY;
  wire [1:0]xbar_to_m06_couplers_BRESP;
  wire xbar_to_m06_couplers_BVALID;
  wire [31:0]xbar_to_m06_couplers_RDATA;
  wire [6:6]xbar_to_m06_couplers_RREADY;
  wire [1:0]xbar_to_m06_couplers_RRESP;
  wire xbar_to_m06_couplers_RVALID;
  wire [223:192]xbar_to_m06_couplers_WDATA;
  wire xbar_to_m06_couplers_WREADY;
  wire [27:24]xbar_to_m06_couplers_WSTRB;
  wire [6:6]xbar_to_m06_couplers_WVALID;
  wire [255:224]xbar_to_m07_couplers_ARADDR;
  wire xbar_to_m07_couplers_ARREADY;
  wire [7:7]xbar_to_m07_couplers_ARVALID;
  wire [255:224]xbar_to_m07_couplers_AWADDR;
  wire xbar_to_m07_couplers_AWREADY;
  wire [7:7]xbar_to_m07_couplers_AWVALID;
  wire [7:7]xbar_to_m07_couplers_BREADY;
  wire [1:0]xbar_to_m07_couplers_BRESP;
  wire xbar_to_m07_couplers_BVALID;
  wire [31:0]xbar_to_m07_couplers_RDATA;
  wire [7:7]xbar_to_m07_couplers_RREADY;
  wire [1:0]xbar_to_m07_couplers_RRESP;
  wire xbar_to_m07_couplers_RVALID;
  wire [255:224]xbar_to_m07_couplers_WDATA;
  wire xbar_to_m07_couplers_WREADY;
  wire [31:28]xbar_to_m07_couplers_WSTRB;
  wire [7:7]xbar_to_m07_couplers_WVALID;
  wire [23:0]NLW_xbar_m_axi_arprot_UNCONNECTED;
  wire [23:0]NLW_xbar_m_axi_awprot_UNCONNECTED;

  assign M00_ACLK_1 = M00_ACLK;
  assign M00_ARESETN_1 = M00_ARESETN[0];
  assign M00_AXI_araddr[31:0] = m00_couplers_to_microblaze_0_axi_periph_ARADDR;
  assign M00_AXI_arvalid = m00_couplers_to_microblaze_0_axi_periph_ARVALID;
  assign M00_AXI_awaddr[31:0] = m00_couplers_to_microblaze_0_axi_periph_AWADDR;
  assign M00_AXI_awvalid = m00_couplers_to_microblaze_0_axi_periph_AWVALID;
  assign M00_AXI_bready = m00_couplers_to_microblaze_0_axi_periph_BREADY;
  assign M00_AXI_rready = m00_couplers_to_microblaze_0_axi_periph_RREADY;
  assign M00_AXI_wdata[31:0] = m00_couplers_to_microblaze_0_axi_periph_WDATA;
  assign M00_AXI_wstrb[3:0] = m00_couplers_to_microblaze_0_axi_periph_WSTRB;
  assign M00_AXI_wvalid = m00_couplers_to_microblaze_0_axi_periph_WVALID;
  assign M01_ACLK_1 = M01_ACLK;
  assign M01_ARESETN_1 = M01_ARESETN[0];
  assign M01_AXI_araddr[31:0] = m01_couplers_to_microblaze_0_axi_periph_ARADDR;
  assign M01_AXI_arprot[2:0] = m01_couplers_to_microblaze_0_axi_periph_ARPROT;
  assign M01_AXI_arvalid = m01_couplers_to_microblaze_0_axi_periph_ARVALID;
  assign M01_AXI_awaddr[31:0] = m01_couplers_to_microblaze_0_axi_periph_AWADDR;
  assign M01_AXI_awprot[2:0] = m01_couplers_to_microblaze_0_axi_periph_AWPROT;
  assign M01_AXI_awvalid = m01_couplers_to_microblaze_0_axi_periph_AWVALID;
  assign M01_AXI_bready = m01_couplers_to_microblaze_0_axi_periph_BREADY;
  assign M01_AXI_rready = m01_couplers_to_microblaze_0_axi_periph_RREADY;
  assign M01_AXI_wdata[31:0] = m01_couplers_to_microblaze_0_axi_periph_WDATA;
  assign M01_AXI_wstrb[3:0] = m01_couplers_to_microblaze_0_axi_periph_WSTRB;
  assign M01_AXI_wvalid = m01_couplers_to_microblaze_0_axi_periph_WVALID;
  assign M02_ACLK_1 = M02_ACLK;
  assign M02_ARESETN_1 = M02_ARESETN[0];
  assign M02_AXI_araddr[31:0] = m02_couplers_to_microblaze_0_axi_periph_ARADDR;
  assign M02_AXI_arprot[2:0] = m02_couplers_to_microblaze_0_axi_periph_ARPROT;
  assign M02_AXI_arvalid = m02_couplers_to_microblaze_0_axi_periph_ARVALID;
  assign M02_AXI_awaddr[31:0] = m02_couplers_to_microblaze_0_axi_periph_AWADDR;
  assign M02_AXI_awprot[2:0] = m02_couplers_to_microblaze_0_axi_periph_AWPROT;
  assign M02_AXI_awvalid = m02_couplers_to_microblaze_0_axi_periph_AWVALID;
  assign M02_AXI_bready = m02_couplers_to_microblaze_0_axi_periph_BREADY;
  assign M02_AXI_rready = m02_couplers_to_microblaze_0_axi_periph_RREADY;
  assign M02_AXI_wdata[31:0] = m02_couplers_to_microblaze_0_axi_periph_WDATA;
  assign M02_AXI_wstrb[3:0] = m02_couplers_to_microblaze_0_axi_periph_WSTRB;
  assign M02_AXI_wvalid = m02_couplers_to_microblaze_0_axi_periph_WVALID;
  assign M03_ACLK_1 = M03_ACLK;
  assign M03_ARESETN_1 = M03_ARESETN[0];
  assign M03_AXI_araddr[31:0] = m03_couplers_to_microblaze_0_axi_periph_ARADDR;
  assign M03_AXI_arprot[2:0] = m03_couplers_to_microblaze_0_axi_periph_ARPROT;
  assign M03_AXI_arvalid = m03_couplers_to_microblaze_0_axi_periph_ARVALID;
  assign M03_AXI_awaddr[31:0] = m03_couplers_to_microblaze_0_axi_periph_AWADDR;
  assign M03_AXI_awprot[2:0] = m03_couplers_to_microblaze_0_axi_periph_AWPROT;
  assign M03_AXI_awvalid = m03_couplers_to_microblaze_0_axi_periph_AWVALID;
  assign M03_AXI_bready = m03_couplers_to_microblaze_0_axi_periph_BREADY;
  assign M03_AXI_rready = m03_couplers_to_microblaze_0_axi_periph_RREADY;
  assign M03_AXI_wdata[31:0] = m03_couplers_to_microblaze_0_axi_periph_WDATA;
  assign M03_AXI_wstrb[3:0] = m03_couplers_to_microblaze_0_axi_periph_WSTRB;
  assign M03_AXI_wvalid = m03_couplers_to_microblaze_0_axi_periph_WVALID;
  assign M04_ACLK_1 = M04_ACLK;
  assign M04_ARESETN_1 = M04_ARESETN[0];
  assign M04_AXI_araddr[31:0] = m04_couplers_to_microblaze_0_axi_periph_ARADDR;
  assign M04_AXI_arprot[2:0] = m04_couplers_to_microblaze_0_axi_periph_ARPROT;
  assign M04_AXI_arvalid = m04_couplers_to_microblaze_0_axi_periph_ARVALID;
  assign M04_AXI_awaddr[31:0] = m04_couplers_to_microblaze_0_axi_periph_AWADDR;
  assign M04_AXI_awprot[2:0] = m04_couplers_to_microblaze_0_axi_periph_AWPROT;
  assign M04_AXI_awvalid = m04_couplers_to_microblaze_0_axi_periph_AWVALID;
  assign M04_AXI_bready = m04_couplers_to_microblaze_0_axi_periph_BREADY;
  assign M04_AXI_rready = m04_couplers_to_microblaze_0_axi_periph_RREADY;
  assign M04_AXI_wdata[31:0] = m04_couplers_to_microblaze_0_axi_periph_WDATA;
  assign M04_AXI_wstrb[3:0] = m04_couplers_to_microblaze_0_axi_periph_WSTRB;
  assign M04_AXI_wvalid = m04_couplers_to_microblaze_0_axi_periph_WVALID;
  assign M05_ACLK_1 = M05_ACLK;
  assign M05_ARESETN_1 = M05_ARESETN[0];
  assign M05_AXI_araddr[31:0] = m05_couplers_to_microblaze_0_axi_periph_ARADDR;
  assign M05_AXI_arprot[2:0] = m05_couplers_to_microblaze_0_axi_periph_ARPROT;
  assign M05_AXI_arvalid = m05_couplers_to_microblaze_0_axi_periph_ARVALID;
  assign M05_AXI_awaddr[31:0] = m05_couplers_to_microblaze_0_axi_periph_AWADDR;
  assign M05_AXI_awprot[2:0] = m05_couplers_to_microblaze_0_axi_periph_AWPROT;
  assign M05_AXI_awvalid = m05_couplers_to_microblaze_0_axi_periph_AWVALID;
  assign M05_AXI_bready = m05_couplers_to_microblaze_0_axi_periph_BREADY;
  assign M05_AXI_rready = m05_couplers_to_microblaze_0_axi_periph_RREADY;
  assign M05_AXI_wdata[31:0] = m05_couplers_to_microblaze_0_axi_periph_WDATA;
  assign M05_AXI_wstrb[3:0] = m05_couplers_to_microblaze_0_axi_periph_WSTRB;
  assign M05_AXI_wvalid = m05_couplers_to_microblaze_0_axi_periph_WVALID;
  assign M06_ACLK_1 = M06_ACLK;
  assign M06_ARESETN_1 = M06_ARESETN[0];
  assign M06_AXI_araddr[31:0] = m06_couplers_to_microblaze_0_axi_periph_ARADDR;
  assign M06_AXI_arvalid = m06_couplers_to_microblaze_0_axi_periph_ARVALID;
  assign M06_AXI_awaddr[31:0] = m06_couplers_to_microblaze_0_axi_periph_AWADDR;
  assign M06_AXI_awvalid = m06_couplers_to_microblaze_0_axi_periph_AWVALID;
  assign M06_AXI_bready = m06_couplers_to_microblaze_0_axi_periph_BREADY;
  assign M06_AXI_rready = m06_couplers_to_microblaze_0_axi_periph_RREADY;
  assign M06_AXI_wdata[31:0] = m06_couplers_to_microblaze_0_axi_periph_WDATA;
  assign M06_AXI_wstrb[3:0] = m06_couplers_to_microblaze_0_axi_periph_WSTRB;
  assign M06_AXI_wvalid = m06_couplers_to_microblaze_0_axi_periph_WVALID;
  assign M07_ACLK_1 = M07_ACLK;
  assign M07_ARESETN_1 = M07_ARESETN[0];
  assign M07_AXI_araddr[31:0] = m07_couplers_to_microblaze_0_axi_periph_ARADDR;
  assign M07_AXI_arvalid = m07_couplers_to_microblaze_0_axi_periph_ARVALID;
  assign M07_AXI_awaddr[31:0] = m07_couplers_to_microblaze_0_axi_periph_AWADDR;
  assign M07_AXI_awvalid = m07_couplers_to_microblaze_0_axi_periph_AWVALID;
  assign M07_AXI_bready = m07_couplers_to_microblaze_0_axi_periph_BREADY;
  assign M07_AXI_rready = m07_couplers_to_microblaze_0_axi_periph_RREADY;
  assign M07_AXI_wdata[31:0] = m07_couplers_to_microblaze_0_axi_periph_WDATA;
  assign M07_AXI_wstrb[3:0] = m07_couplers_to_microblaze_0_axi_periph_WSTRB;
  assign M07_AXI_wvalid = m07_couplers_to_microblaze_0_axi_periph_WVALID;
  assign S00_ACLK_1 = S00_ACLK;
  assign S00_ARESETN_1 = S00_ARESETN[0];
  assign S00_AXI_arready[0] = microblaze_0_axi_periph_to_s00_couplers_ARREADY;
  assign S00_AXI_awready[0] = microblaze_0_axi_periph_to_s00_couplers_AWREADY;
  assign S00_AXI_bresp[1:0] = microblaze_0_axi_periph_to_s00_couplers_BRESP;
  assign S00_AXI_bvalid[0] = microblaze_0_axi_periph_to_s00_couplers_BVALID;
  assign S00_AXI_rdata[31:0] = microblaze_0_axi_periph_to_s00_couplers_RDATA;
  assign S00_AXI_rresp[1:0] = microblaze_0_axi_periph_to_s00_couplers_RRESP;
  assign S00_AXI_rvalid[0] = microblaze_0_axi_periph_to_s00_couplers_RVALID;
  assign S00_AXI_wready[0] = microblaze_0_axi_periph_to_s00_couplers_WREADY;
  assign m00_couplers_to_microblaze_0_axi_periph_ARREADY = M00_AXI_arready;
  assign m00_couplers_to_microblaze_0_axi_periph_AWREADY = M00_AXI_awready;
  assign m00_couplers_to_microblaze_0_axi_periph_BRESP = M00_AXI_bresp[1:0];
  assign m00_couplers_to_microblaze_0_axi_periph_BVALID = M00_AXI_bvalid;
  assign m00_couplers_to_microblaze_0_axi_periph_RDATA = M00_AXI_rdata[31:0];
  assign m00_couplers_to_microblaze_0_axi_periph_RRESP = M00_AXI_rresp[1:0];
  assign m00_couplers_to_microblaze_0_axi_periph_RVALID = M00_AXI_rvalid;
  assign m00_couplers_to_microblaze_0_axi_periph_WREADY = M00_AXI_wready;
  assign m01_couplers_to_microblaze_0_axi_periph_ARREADY = M01_AXI_arready;
  assign m01_couplers_to_microblaze_0_axi_periph_AWREADY = M01_AXI_awready;
  assign m01_couplers_to_microblaze_0_axi_periph_BRESP = M01_AXI_bresp[1:0];
  assign m01_couplers_to_microblaze_0_axi_periph_BVALID = M01_AXI_bvalid;
  assign m01_couplers_to_microblaze_0_axi_periph_RDATA = M01_AXI_rdata[31:0];
  assign m01_couplers_to_microblaze_0_axi_periph_RRESP = M01_AXI_rresp[1:0];
  assign m01_couplers_to_microblaze_0_axi_periph_RVALID = M01_AXI_rvalid;
  assign m01_couplers_to_microblaze_0_axi_periph_WREADY = M01_AXI_wready;
  assign m02_couplers_to_microblaze_0_axi_periph_ARREADY = M02_AXI_arready;
  assign m02_couplers_to_microblaze_0_axi_periph_AWREADY = M02_AXI_awready;
  assign m02_couplers_to_microblaze_0_axi_periph_BRESP = M02_AXI_bresp[1:0];
  assign m02_couplers_to_microblaze_0_axi_periph_BVALID = M02_AXI_bvalid;
  assign m02_couplers_to_microblaze_0_axi_periph_RDATA = M02_AXI_rdata[31:0];
  assign m02_couplers_to_microblaze_0_axi_periph_RRESP = M02_AXI_rresp[1:0];
  assign m02_couplers_to_microblaze_0_axi_periph_RVALID = M02_AXI_rvalid;
  assign m02_couplers_to_microblaze_0_axi_periph_WREADY = M02_AXI_wready;
  assign m03_couplers_to_microblaze_0_axi_periph_ARREADY = M03_AXI_arready;
  assign m03_couplers_to_microblaze_0_axi_periph_AWREADY = M03_AXI_awready;
  assign m03_couplers_to_microblaze_0_axi_periph_BRESP = M03_AXI_bresp[1:0];
  assign m03_couplers_to_microblaze_0_axi_periph_BVALID = M03_AXI_bvalid;
  assign m03_couplers_to_microblaze_0_axi_periph_RDATA = M03_AXI_rdata[31:0];
  assign m03_couplers_to_microblaze_0_axi_periph_RRESP = M03_AXI_rresp[1:0];
  assign m03_couplers_to_microblaze_0_axi_periph_RVALID = M03_AXI_rvalid;
  assign m03_couplers_to_microblaze_0_axi_periph_WREADY = M03_AXI_wready;
  assign m04_couplers_to_microblaze_0_axi_periph_ARREADY = M04_AXI_arready;
  assign m04_couplers_to_microblaze_0_axi_periph_AWREADY = M04_AXI_awready;
  assign m04_couplers_to_microblaze_0_axi_periph_BRESP = M04_AXI_bresp[1:0];
  assign m04_couplers_to_microblaze_0_axi_periph_BVALID = M04_AXI_bvalid;
  assign m04_couplers_to_microblaze_0_axi_periph_RDATA = M04_AXI_rdata[31:0];
  assign m04_couplers_to_microblaze_0_axi_periph_RRESP = M04_AXI_rresp[1:0];
  assign m04_couplers_to_microblaze_0_axi_periph_RVALID = M04_AXI_rvalid;
  assign m04_couplers_to_microblaze_0_axi_periph_WREADY = M04_AXI_wready;
  assign m05_couplers_to_microblaze_0_axi_periph_ARREADY = M05_AXI_arready;
  assign m05_couplers_to_microblaze_0_axi_periph_AWREADY = M05_AXI_awready;
  assign m05_couplers_to_microblaze_0_axi_periph_BRESP = M05_AXI_bresp[1:0];
  assign m05_couplers_to_microblaze_0_axi_periph_BVALID = M05_AXI_bvalid;
  assign m05_couplers_to_microblaze_0_axi_periph_RDATA = M05_AXI_rdata[31:0];
  assign m05_couplers_to_microblaze_0_axi_periph_RRESP = M05_AXI_rresp[1:0];
  assign m05_couplers_to_microblaze_0_axi_periph_RVALID = M05_AXI_rvalid;
  assign m05_couplers_to_microblaze_0_axi_periph_WREADY = M05_AXI_wready;
  assign m06_couplers_to_microblaze_0_axi_periph_ARREADY = M06_AXI_arready;
  assign m06_couplers_to_microblaze_0_axi_periph_AWREADY = M06_AXI_awready;
  assign m06_couplers_to_microblaze_0_axi_periph_BRESP = M06_AXI_bresp[1:0];
  assign m06_couplers_to_microblaze_0_axi_periph_BVALID = M06_AXI_bvalid;
  assign m06_couplers_to_microblaze_0_axi_periph_RDATA = M06_AXI_rdata[31:0];
  assign m06_couplers_to_microblaze_0_axi_periph_RRESP = M06_AXI_rresp[1:0];
  assign m06_couplers_to_microblaze_0_axi_periph_RVALID = M06_AXI_rvalid;
  assign m06_couplers_to_microblaze_0_axi_periph_WREADY = M06_AXI_wready;
  assign m07_couplers_to_microblaze_0_axi_periph_ARREADY = M07_AXI_arready;
  assign m07_couplers_to_microblaze_0_axi_periph_AWREADY = M07_AXI_awready;
  assign m07_couplers_to_microblaze_0_axi_periph_BRESP = M07_AXI_bresp[1:0];
  assign m07_couplers_to_microblaze_0_axi_periph_BVALID = M07_AXI_bvalid;
  assign m07_couplers_to_microblaze_0_axi_periph_RDATA = M07_AXI_rdata[31:0];
  assign m07_couplers_to_microblaze_0_axi_periph_RRESP = M07_AXI_rresp[1:0];
  assign m07_couplers_to_microblaze_0_axi_periph_RVALID = M07_AXI_rvalid;
  assign m07_couplers_to_microblaze_0_axi_periph_WREADY = M07_AXI_wready;
  assign microblaze_0_axi_periph_ACLK_net = ACLK;
  assign microblaze_0_axi_periph_ARESETN_net = ARESETN[0];
  assign microblaze_0_axi_periph_to_s00_couplers_ARADDR = S00_AXI_araddr[31:0];
  assign microblaze_0_axi_periph_to_s00_couplers_ARPROT = S00_AXI_arprot[2:0];
  assign microblaze_0_axi_periph_to_s00_couplers_ARVALID = S00_AXI_arvalid[0];
  assign microblaze_0_axi_periph_to_s00_couplers_AWADDR = S00_AXI_awaddr[31:0];
  assign microblaze_0_axi_periph_to_s00_couplers_AWPROT = S00_AXI_awprot[2:0];
  assign microblaze_0_axi_periph_to_s00_couplers_AWVALID = S00_AXI_awvalid[0];
  assign microblaze_0_axi_periph_to_s00_couplers_BREADY = S00_AXI_bready[0];
  assign microblaze_0_axi_periph_to_s00_couplers_RREADY = S00_AXI_rready[0];
  assign microblaze_0_axi_periph_to_s00_couplers_WDATA = S00_AXI_wdata[31:0];
  assign microblaze_0_axi_periph_to_s00_couplers_WSTRB = S00_AXI_wstrb[3:0];
  assign microblaze_0_axi_periph_to_s00_couplers_WVALID = S00_AXI_wvalid[0];
  m00_couplers_imp_5YRABW m00_couplers
       (.M_ACLK(M00_ACLK_1),
        .M_ARESETN(M00_ARESETN_1),
        .M_AXI_araddr(m00_couplers_to_microblaze_0_axi_periph_ARADDR),
        .M_AXI_arready(m00_couplers_to_microblaze_0_axi_periph_ARREADY),
        .M_AXI_arvalid(m00_couplers_to_microblaze_0_axi_periph_ARVALID),
        .M_AXI_awaddr(m00_couplers_to_microblaze_0_axi_periph_AWADDR),
        .M_AXI_awready(m00_couplers_to_microblaze_0_axi_periph_AWREADY),
        .M_AXI_awvalid(m00_couplers_to_microblaze_0_axi_periph_AWVALID),
        .M_AXI_bready(m00_couplers_to_microblaze_0_axi_periph_BREADY),
        .M_AXI_bresp(m00_couplers_to_microblaze_0_axi_periph_BRESP),
        .M_AXI_bvalid(m00_couplers_to_microblaze_0_axi_periph_BVALID),
        .M_AXI_rdata(m00_couplers_to_microblaze_0_axi_periph_RDATA),
        .M_AXI_rready(m00_couplers_to_microblaze_0_axi_periph_RREADY),
        .M_AXI_rresp(m00_couplers_to_microblaze_0_axi_periph_RRESP),
        .M_AXI_rvalid(m00_couplers_to_microblaze_0_axi_periph_RVALID),
        .M_AXI_wdata(m00_couplers_to_microblaze_0_axi_periph_WDATA),
        .M_AXI_wready(m00_couplers_to_microblaze_0_axi_periph_WREADY),
        .M_AXI_wstrb(m00_couplers_to_microblaze_0_axi_periph_WSTRB),
        .M_AXI_wvalid(m00_couplers_to_microblaze_0_axi_periph_WVALID),
        .S_ACLK(microblaze_0_axi_periph_ACLK_net),
        .S_ARESETN(microblaze_0_axi_periph_ARESETN_net),
        .S_AXI_araddr(xbar_to_m00_couplers_ARADDR),
        .S_AXI_arready(xbar_to_m00_couplers_ARREADY),
        .S_AXI_arvalid(xbar_to_m00_couplers_ARVALID),
        .S_AXI_awaddr(xbar_to_m00_couplers_AWADDR),
        .S_AXI_awready(xbar_to_m00_couplers_AWREADY),
        .S_AXI_awvalid(xbar_to_m00_couplers_AWVALID),
        .S_AXI_bready(xbar_to_m00_couplers_BREADY),
        .S_AXI_bresp(xbar_to_m00_couplers_BRESP),
        .S_AXI_bvalid(xbar_to_m00_couplers_BVALID),
        .S_AXI_rdata(xbar_to_m00_couplers_RDATA),
        .S_AXI_rready(xbar_to_m00_couplers_RREADY),
        .S_AXI_rresp(xbar_to_m00_couplers_RRESP),
        .S_AXI_rvalid(xbar_to_m00_couplers_RVALID),
        .S_AXI_wdata(xbar_to_m00_couplers_WDATA),
        .S_AXI_wready(xbar_to_m00_couplers_WREADY),
        .S_AXI_wstrb(xbar_to_m00_couplers_WSTRB),
        .S_AXI_wvalid(xbar_to_m00_couplers_WVALID));
  m01_couplers_imp_WVYWX4 m01_couplers
       (.M_ACLK(M01_ACLK_1),
        .M_ARESETN(M01_ARESETN_1),
        .M_AXI_araddr(m01_couplers_to_microblaze_0_axi_periph_ARADDR),
        .M_AXI_arprot(m01_couplers_to_microblaze_0_axi_periph_ARPROT),
        .M_AXI_arready(m01_couplers_to_microblaze_0_axi_periph_ARREADY),
        .M_AXI_arvalid(m01_couplers_to_microblaze_0_axi_periph_ARVALID),
        .M_AXI_awaddr(m01_couplers_to_microblaze_0_axi_periph_AWADDR),
        .M_AXI_awprot(m01_couplers_to_microblaze_0_axi_periph_AWPROT),
        .M_AXI_awready(m01_couplers_to_microblaze_0_axi_periph_AWREADY),
        .M_AXI_awvalid(m01_couplers_to_microblaze_0_axi_periph_AWVALID),
        .M_AXI_bready(m01_couplers_to_microblaze_0_axi_periph_BREADY),
        .M_AXI_bresp(m01_couplers_to_microblaze_0_axi_periph_BRESP),
        .M_AXI_bvalid(m01_couplers_to_microblaze_0_axi_periph_BVALID),
        .M_AXI_rdata(m01_couplers_to_microblaze_0_axi_periph_RDATA),
        .M_AXI_rready(m01_couplers_to_microblaze_0_axi_periph_RREADY),
        .M_AXI_rresp(m01_couplers_to_microblaze_0_axi_periph_RRESP),
        .M_AXI_rvalid(m01_couplers_to_microblaze_0_axi_periph_RVALID),
        .M_AXI_wdata(m01_couplers_to_microblaze_0_axi_periph_WDATA),
        .M_AXI_wready(m01_couplers_to_microblaze_0_axi_periph_WREADY),
        .M_AXI_wstrb(m01_couplers_to_microblaze_0_axi_periph_WSTRB),
        .M_AXI_wvalid(m01_couplers_to_microblaze_0_axi_periph_WVALID),
        .S_ACLK(microblaze_0_axi_periph_ACLK_net),
        .S_ARESETN(microblaze_0_axi_periph_ARESETN_net),
        .S_AXI_araddr(xbar_to_m01_couplers_ARADDR),
        .S_AXI_arprot(xbar_to_m01_couplers_ARPROT),
        .S_AXI_arready(xbar_to_m01_couplers_ARREADY),
        .S_AXI_arvalid(xbar_to_m01_couplers_ARVALID),
        .S_AXI_awaddr(xbar_to_m01_couplers_AWADDR),
        .S_AXI_awprot(xbar_to_m01_couplers_AWPROT),
        .S_AXI_awready(xbar_to_m01_couplers_AWREADY),
        .S_AXI_awvalid(xbar_to_m01_couplers_AWVALID),
        .S_AXI_bready(xbar_to_m01_couplers_BREADY),
        .S_AXI_bresp(xbar_to_m01_couplers_BRESP),
        .S_AXI_bvalid(xbar_to_m01_couplers_BVALID),
        .S_AXI_rdata(xbar_to_m01_couplers_RDATA),
        .S_AXI_rready(xbar_to_m01_couplers_RREADY),
        .S_AXI_rresp(xbar_to_m01_couplers_RRESP),
        .S_AXI_rvalid(xbar_to_m01_couplers_RVALID),
        .S_AXI_wdata(xbar_to_m01_couplers_WDATA),
        .S_AXI_wready(xbar_to_m01_couplers_WREADY),
        .S_AXI_wstrb(xbar_to_m01_couplers_WSTRB),
        .S_AXI_wvalid(xbar_to_m01_couplers_WVALID));
  m02_couplers_imp_1MP85Z8 m02_couplers
       (.M_ACLK(M02_ACLK_1),
        .M_ARESETN(M02_ARESETN_1),
        .M_AXI_araddr(m02_couplers_to_microblaze_0_axi_periph_ARADDR),
        .M_AXI_arprot(m02_couplers_to_microblaze_0_axi_periph_ARPROT),
        .M_AXI_arready(m02_couplers_to_microblaze_0_axi_periph_ARREADY),
        .M_AXI_arvalid(m02_couplers_to_microblaze_0_axi_periph_ARVALID),
        .M_AXI_awaddr(m02_couplers_to_microblaze_0_axi_periph_AWADDR),
        .M_AXI_awprot(m02_couplers_to_microblaze_0_axi_periph_AWPROT),
        .M_AXI_awready(m02_couplers_to_microblaze_0_axi_periph_AWREADY),
        .M_AXI_awvalid(m02_couplers_to_microblaze_0_axi_periph_AWVALID),
        .M_AXI_bready(m02_couplers_to_microblaze_0_axi_periph_BREADY),
        .M_AXI_bresp(m02_couplers_to_microblaze_0_axi_periph_BRESP),
        .M_AXI_bvalid(m02_couplers_to_microblaze_0_axi_periph_BVALID),
        .M_AXI_rdata(m02_couplers_to_microblaze_0_axi_periph_RDATA),
        .M_AXI_rready(m02_couplers_to_microblaze_0_axi_periph_RREADY),
        .M_AXI_rresp(m02_couplers_to_microblaze_0_axi_periph_RRESP),
        .M_AXI_rvalid(m02_couplers_to_microblaze_0_axi_periph_RVALID),
        .M_AXI_wdata(m02_couplers_to_microblaze_0_axi_periph_WDATA),
        .M_AXI_wready(m02_couplers_to_microblaze_0_axi_periph_WREADY),
        .M_AXI_wstrb(m02_couplers_to_microblaze_0_axi_periph_WSTRB),
        .M_AXI_wvalid(m02_couplers_to_microblaze_0_axi_periph_WVALID),
        .S_ACLK(microblaze_0_axi_periph_ACLK_net),
        .S_ARESETN(microblaze_0_axi_periph_ARESETN_net),
        .S_AXI_araddr(xbar_to_m02_couplers_ARADDR),
        .S_AXI_arprot(xbar_to_m02_couplers_ARPROT),
        .S_AXI_arready(xbar_to_m02_couplers_ARREADY),
        .S_AXI_arvalid(xbar_to_m02_couplers_ARVALID),
        .S_AXI_awaddr(xbar_to_m02_couplers_AWADDR),
        .S_AXI_awprot(xbar_to_m02_couplers_AWPROT),
        .S_AXI_awready(xbar_to_m02_couplers_AWREADY),
        .S_AXI_awvalid(xbar_to_m02_couplers_AWVALID),
        .S_AXI_bready(xbar_to_m02_couplers_BREADY),
        .S_AXI_bresp(xbar_to_m02_couplers_BRESP),
        .S_AXI_bvalid(xbar_to_m02_couplers_BVALID),
        .S_AXI_rdata(xbar_to_m02_couplers_RDATA),
        .S_AXI_rready(xbar_to_m02_couplers_RREADY),
        .S_AXI_rresp(xbar_to_m02_couplers_RRESP),
        .S_AXI_rvalid(xbar_to_m02_couplers_RVALID),
        .S_AXI_wdata(xbar_to_m02_couplers_WDATA),
        .S_AXI_wready(xbar_to_m02_couplers_WREADY),
        .S_AXI_wstrb(xbar_to_m02_couplers_WSTRB),
        .S_AXI_wvalid(xbar_to_m02_couplers_WVALID));
  m03_couplers_imp_1CZC57K m03_couplers
       (.M_ACLK(M03_ACLK_1),
        .M_ARESETN(M03_ARESETN_1),
        .M_AXI_araddr(m03_couplers_to_microblaze_0_axi_periph_ARADDR),
        .M_AXI_arprot(m03_couplers_to_microblaze_0_axi_periph_ARPROT),
        .M_AXI_arready(m03_couplers_to_microblaze_0_axi_periph_ARREADY),
        .M_AXI_arvalid(m03_couplers_to_microblaze_0_axi_periph_ARVALID),
        .M_AXI_awaddr(m03_couplers_to_microblaze_0_axi_periph_AWADDR),
        .M_AXI_awprot(m03_couplers_to_microblaze_0_axi_periph_AWPROT),
        .M_AXI_awready(m03_couplers_to_microblaze_0_axi_periph_AWREADY),
        .M_AXI_awvalid(m03_couplers_to_microblaze_0_axi_periph_AWVALID),
        .M_AXI_bready(m03_couplers_to_microblaze_0_axi_periph_BREADY),
        .M_AXI_bresp(m03_couplers_to_microblaze_0_axi_periph_BRESP),
        .M_AXI_bvalid(m03_couplers_to_microblaze_0_axi_periph_BVALID),
        .M_AXI_rdata(m03_couplers_to_microblaze_0_axi_periph_RDATA),
        .M_AXI_rready(m03_couplers_to_microblaze_0_axi_periph_RREADY),
        .M_AXI_rresp(m03_couplers_to_microblaze_0_axi_periph_RRESP),
        .M_AXI_rvalid(m03_couplers_to_microblaze_0_axi_periph_RVALID),
        .M_AXI_wdata(m03_couplers_to_microblaze_0_axi_periph_WDATA),
        .M_AXI_wready(m03_couplers_to_microblaze_0_axi_periph_WREADY),
        .M_AXI_wstrb(m03_couplers_to_microblaze_0_axi_periph_WSTRB),
        .M_AXI_wvalid(m03_couplers_to_microblaze_0_axi_periph_WVALID),
        .S_ACLK(microblaze_0_axi_periph_ACLK_net),
        .S_ARESETN(microblaze_0_axi_periph_ARESETN_net),
        .S_AXI_araddr(xbar_to_m03_couplers_ARADDR),
        .S_AXI_arprot(xbar_to_m03_couplers_ARPROT),
        .S_AXI_arready(xbar_to_m03_couplers_ARREADY),
        .S_AXI_arvalid(xbar_to_m03_couplers_ARVALID),
        .S_AXI_awaddr(xbar_to_m03_couplers_AWADDR),
        .S_AXI_awprot(xbar_to_m03_couplers_AWPROT),
        .S_AXI_awready(xbar_to_m03_couplers_AWREADY),
        .S_AXI_awvalid(xbar_to_m03_couplers_AWVALID),
        .S_AXI_bready(xbar_to_m03_couplers_BREADY),
        .S_AXI_bresp(xbar_to_m03_couplers_BRESP),
        .S_AXI_bvalid(xbar_to_m03_couplers_BVALID),
        .S_AXI_rdata(xbar_to_m03_couplers_RDATA),
        .S_AXI_rready(xbar_to_m03_couplers_RREADY),
        .S_AXI_rresp(xbar_to_m03_couplers_RRESP),
        .S_AXI_rvalid(xbar_to_m03_couplers_RVALID),
        .S_AXI_wdata(xbar_to_m03_couplers_WDATA),
        .S_AXI_wready(xbar_to_m03_couplers_WREADY),
        .S_AXI_wstrb(xbar_to_m03_couplers_WSTRB),
        .S_AXI_wvalid(xbar_to_m03_couplers_WVALID));
  m04_couplers_imp_IKK1R1 m04_couplers
       (.M_ACLK(M04_ACLK_1),
        .M_ARESETN(M04_ARESETN_1),
        .M_AXI_araddr(m04_couplers_to_microblaze_0_axi_periph_ARADDR),
        .M_AXI_arprot(m04_couplers_to_microblaze_0_axi_periph_ARPROT),
        .M_AXI_arready(m04_couplers_to_microblaze_0_axi_periph_ARREADY),
        .M_AXI_arvalid(m04_couplers_to_microblaze_0_axi_periph_ARVALID),
        .M_AXI_awaddr(m04_couplers_to_microblaze_0_axi_periph_AWADDR),
        .M_AXI_awprot(m04_couplers_to_microblaze_0_axi_periph_AWPROT),
        .M_AXI_awready(m04_couplers_to_microblaze_0_axi_periph_AWREADY),
        .M_AXI_awvalid(m04_couplers_to_microblaze_0_axi_periph_AWVALID),
        .M_AXI_bready(m04_couplers_to_microblaze_0_axi_periph_BREADY),
        .M_AXI_bresp(m04_couplers_to_microblaze_0_axi_periph_BRESP),
        .M_AXI_bvalid(m04_couplers_to_microblaze_0_axi_periph_BVALID),
        .M_AXI_rdata(m04_couplers_to_microblaze_0_axi_periph_RDATA),
        .M_AXI_rready(m04_couplers_to_microblaze_0_axi_periph_RREADY),
        .M_AXI_rresp(m04_couplers_to_microblaze_0_axi_periph_RRESP),
        .M_AXI_rvalid(m04_couplers_to_microblaze_0_axi_periph_RVALID),
        .M_AXI_wdata(m04_couplers_to_microblaze_0_axi_periph_WDATA),
        .M_AXI_wready(m04_couplers_to_microblaze_0_axi_periph_WREADY),
        .M_AXI_wstrb(m04_couplers_to_microblaze_0_axi_periph_WSTRB),
        .M_AXI_wvalid(m04_couplers_to_microblaze_0_axi_periph_WVALID),
        .S_ACLK(microblaze_0_axi_periph_ACLK_net),
        .S_ARESETN(microblaze_0_axi_periph_ARESETN_net),
        .S_AXI_araddr(xbar_to_m04_couplers_ARADDR),
        .S_AXI_arprot(xbar_to_m04_couplers_ARPROT),
        .S_AXI_arready(xbar_to_m04_couplers_ARREADY),
        .S_AXI_arvalid(xbar_to_m04_couplers_ARVALID),
        .S_AXI_awaddr(xbar_to_m04_couplers_AWADDR),
        .S_AXI_awprot(xbar_to_m04_couplers_AWPROT),
        .S_AXI_awready(xbar_to_m04_couplers_AWREADY),
        .S_AXI_awvalid(xbar_to_m04_couplers_AWVALID),
        .S_AXI_bready(xbar_to_m04_couplers_BREADY),
        .S_AXI_bresp(xbar_to_m04_couplers_BRESP),
        .S_AXI_bvalid(xbar_to_m04_couplers_BVALID),
        .S_AXI_rdata(xbar_to_m04_couplers_RDATA),
        .S_AXI_rready(xbar_to_m04_couplers_RREADY),
        .S_AXI_rresp(xbar_to_m04_couplers_RRESP),
        .S_AXI_rvalid(xbar_to_m04_couplers_RVALID),
        .S_AXI_wdata(xbar_to_m04_couplers_WDATA),
        .S_AXI_wready(xbar_to_m04_couplers_WREADY),
        .S_AXI_wstrb(xbar_to_m04_couplers_WSTRB),
        .S_AXI_wvalid(xbar_to_m04_couplers_WVALID));
  m05_couplers_imp_9EQWHL m05_couplers
       (.M_ACLK(M05_ACLK_1),
        .M_ARESETN(M05_ARESETN_1),
        .M_AXI_araddr(m05_couplers_to_microblaze_0_axi_periph_ARADDR),
        .M_AXI_arprot(m05_couplers_to_microblaze_0_axi_periph_ARPROT),
        .M_AXI_arready(m05_couplers_to_microblaze_0_axi_periph_ARREADY),
        .M_AXI_arvalid(m05_couplers_to_microblaze_0_axi_periph_ARVALID),
        .M_AXI_awaddr(m05_couplers_to_microblaze_0_axi_periph_AWADDR),
        .M_AXI_awprot(m05_couplers_to_microblaze_0_axi_periph_AWPROT),
        .M_AXI_awready(m05_couplers_to_microblaze_0_axi_periph_AWREADY),
        .M_AXI_awvalid(m05_couplers_to_microblaze_0_axi_periph_AWVALID),
        .M_AXI_bready(m05_couplers_to_microblaze_0_axi_periph_BREADY),
        .M_AXI_bresp(m05_couplers_to_microblaze_0_axi_periph_BRESP),
        .M_AXI_bvalid(m05_couplers_to_microblaze_0_axi_periph_BVALID),
        .M_AXI_rdata(m05_couplers_to_microblaze_0_axi_periph_RDATA),
        .M_AXI_rready(m05_couplers_to_microblaze_0_axi_periph_RREADY),
        .M_AXI_rresp(m05_couplers_to_microblaze_0_axi_periph_RRESP),
        .M_AXI_rvalid(m05_couplers_to_microblaze_0_axi_periph_RVALID),
        .M_AXI_wdata(m05_couplers_to_microblaze_0_axi_periph_WDATA),
        .M_AXI_wready(m05_couplers_to_microblaze_0_axi_periph_WREADY),
        .M_AXI_wstrb(m05_couplers_to_microblaze_0_axi_periph_WSTRB),
        .M_AXI_wvalid(m05_couplers_to_microblaze_0_axi_periph_WVALID),
        .S_ACLK(microblaze_0_axi_periph_ACLK_net),
        .S_ARESETN(microblaze_0_axi_periph_ARESETN_net),
        .S_AXI_araddr(xbar_to_m05_couplers_ARADDR),
        .S_AXI_arprot(xbar_to_m05_couplers_ARPROT),
        .S_AXI_arready(xbar_to_m05_couplers_ARREADY),
        .S_AXI_arvalid(xbar_to_m05_couplers_ARVALID),
        .S_AXI_awaddr(xbar_to_m05_couplers_AWADDR),
        .S_AXI_awprot(xbar_to_m05_couplers_AWPROT),
        .S_AXI_awready(xbar_to_m05_couplers_AWREADY),
        .S_AXI_awvalid(xbar_to_m05_couplers_AWVALID),
        .S_AXI_bready(xbar_to_m05_couplers_BREADY),
        .S_AXI_bresp(xbar_to_m05_couplers_BRESP),
        .S_AXI_bvalid(xbar_to_m05_couplers_BVALID),
        .S_AXI_rdata(xbar_to_m05_couplers_RDATA),
        .S_AXI_rready(xbar_to_m05_couplers_RREADY),
        .S_AXI_rresp(xbar_to_m05_couplers_RRESP),
        .S_AXI_rvalid(xbar_to_m05_couplers_RVALID),
        .S_AXI_wdata(xbar_to_m05_couplers_WDATA),
        .S_AXI_wready(xbar_to_m05_couplers_WREADY),
        .S_AXI_wstrb(xbar_to_m05_couplers_WSTRB),
        .S_AXI_wvalid(xbar_to_m05_couplers_WVALID));
  m06_couplers_imp_10VBM39 m06_couplers
       (.M_ACLK(M06_ACLK_1),
        .M_ARESETN(M06_ARESETN_1),
        .M_AXI_araddr(m06_couplers_to_microblaze_0_axi_periph_ARADDR),
        .M_AXI_arready(m06_couplers_to_microblaze_0_axi_periph_ARREADY),
        .M_AXI_arvalid(m06_couplers_to_microblaze_0_axi_periph_ARVALID),
        .M_AXI_awaddr(m06_couplers_to_microblaze_0_axi_periph_AWADDR),
        .M_AXI_awready(m06_couplers_to_microblaze_0_axi_periph_AWREADY),
        .M_AXI_awvalid(m06_couplers_to_microblaze_0_axi_periph_AWVALID),
        .M_AXI_bready(m06_couplers_to_microblaze_0_axi_periph_BREADY),
        .M_AXI_bresp(m06_couplers_to_microblaze_0_axi_periph_BRESP),
        .M_AXI_bvalid(m06_couplers_to_microblaze_0_axi_periph_BVALID),
        .M_AXI_rdata(m06_couplers_to_microblaze_0_axi_periph_RDATA),
        .M_AXI_rready(m06_couplers_to_microblaze_0_axi_periph_RREADY),
        .M_AXI_rresp(m06_couplers_to_microblaze_0_axi_periph_RRESP),
        .M_AXI_rvalid(m06_couplers_to_microblaze_0_axi_periph_RVALID),
        .M_AXI_wdata(m06_couplers_to_microblaze_0_axi_periph_WDATA),
        .M_AXI_wready(m06_couplers_to_microblaze_0_axi_periph_WREADY),
        .M_AXI_wstrb(m06_couplers_to_microblaze_0_axi_periph_WSTRB),
        .M_AXI_wvalid(m06_couplers_to_microblaze_0_axi_periph_WVALID),
        .S_ACLK(microblaze_0_axi_periph_ACLK_net),
        .S_ARESETN(microblaze_0_axi_periph_ARESETN_net),
        .S_AXI_araddr(xbar_to_m06_couplers_ARADDR),
        .S_AXI_arready(xbar_to_m06_couplers_ARREADY),
        .S_AXI_arvalid(xbar_to_m06_couplers_ARVALID),
        .S_AXI_awaddr(xbar_to_m06_couplers_AWADDR),
        .S_AXI_awready(xbar_to_m06_couplers_AWREADY),
        .S_AXI_awvalid(xbar_to_m06_couplers_AWVALID),
        .S_AXI_bready(xbar_to_m06_couplers_BREADY),
        .S_AXI_bresp(xbar_to_m06_couplers_BRESP),
        .S_AXI_bvalid(xbar_to_m06_couplers_BVALID),
        .S_AXI_rdata(xbar_to_m06_couplers_RDATA),
        .S_AXI_rready(xbar_to_m06_couplers_RREADY),
        .S_AXI_rresp(xbar_to_m06_couplers_RRESP),
        .S_AXI_rvalid(xbar_to_m06_couplers_RVALID),
        .S_AXI_wdata(xbar_to_m06_couplers_WDATA),
        .S_AXI_wready(xbar_to_m06_couplers_WREADY),
        .S_AXI_wstrb(xbar_to_m06_couplers_WSTRB),
        .S_AXI_wvalid(xbar_to_m06_couplers_WVALID));
  m07_couplers_imp_1SCDC4X m07_couplers
       (.M_ACLK(M07_ACLK_1),
        .M_ARESETN(M07_ARESETN_1),
        .M_AXI_araddr(m07_couplers_to_microblaze_0_axi_periph_ARADDR),
        .M_AXI_arready(m07_couplers_to_microblaze_0_axi_periph_ARREADY),
        .M_AXI_arvalid(m07_couplers_to_microblaze_0_axi_periph_ARVALID),
        .M_AXI_awaddr(m07_couplers_to_microblaze_0_axi_periph_AWADDR),
        .M_AXI_awready(m07_couplers_to_microblaze_0_axi_periph_AWREADY),
        .M_AXI_awvalid(m07_couplers_to_microblaze_0_axi_periph_AWVALID),
        .M_AXI_bready(m07_couplers_to_microblaze_0_axi_periph_BREADY),
        .M_AXI_bresp(m07_couplers_to_microblaze_0_axi_periph_BRESP),
        .M_AXI_bvalid(m07_couplers_to_microblaze_0_axi_periph_BVALID),
        .M_AXI_rdata(m07_couplers_to_microblaze_0_axi_periph_RDATA),
        .M_AXI_rready(m07_couplers_to_microblaze_0_axi_periph_RREADY),
        .M_AXI_rresp(m07_couplers_to_microblaze_0_axi_periph_RRESP),
        .M_AXI_rvalid(m07_couplers_to_microblaze_0_axi_periph_RVALID),
        .M_AXI_wdata(m07_couplers_to_microblaze_0_axi_periph_WDATA),
        .M_AXI_wready(m07_couplers_to_microblaze_0_axi_periph_WREADY),
        .M_AXI_wstrb(m07_couplers_to_microblaze_0_axi_periph_WSTRB),
        .M_AXI_wvalid(m07_couplers_to_microblaze_0_axi_periph_WVALID),
        .S_ACLK(microblaze_0_axi_periph_ACLK_net),
        .S_ARESETN(microblaze_0_axi_periph_ARESETN_net),
        .S_AXI_araddr(xbar_to_m07_couplers_ARADDR),
        .S_AXI_arready(xbar_to_m07_couplers_ARREADY),
        .S_AXI_arvalid(xbar_to_m07_couplers_ARVALID),
        .S_AXI_awaddr(xbar_to_m07_couplers_AWADDR),
        .S_AXI_awready(xbar_to_m07_couplers_AWREADY),
        .S_AXI_awvalid(xbar_to_m07_couplers_AWVALID),
        .S_AXI_bready(xbar_to_m07_couplers_BREADY),
        .S_AXI_bresp(xbar_to_m07_couplers_BRESP),
        .S_AXI_bvalid(xbar_to_m07_couplers_BVALID),
        .S_AXI_rdata(xbar_to_m07_couplers_RDATA),
        .S_AXI_rready(xbar_to_m07_couplers_RREADY),
        .S_AXI_rresp(xbar_to_m07_couplers_RRESP),
        .S_AXI_rvalid(xbar_to_m07_couplers_RVALID),
        .S_AXI_wdata(xbar_to_m07_couplers_WDATA),
        .S_AXI_wready(xbar_to_m07_couplers_WREADY),
        .S_AXI_wstrb(xbar_to_m07_couplers_WSTRB),
        .S_AXI_wvalid(xbar_to_m07_couplers_WVALID));
  s00_couplers_imp_1BBRO8I s00_couplers
       (.M_ACLK(microblaze_0_axi_periph_ACLK_net),
        .M_ARESETN(microblaze_0_axi_periph_ARESETN_net),
        .M_AXI_araddr(s00_couplers_to_xbar_ARADDR),
        .M_AXI_arprot(s00_couplers_to_xbar_ARPROT),
        .M_AXI_arready(s00_couplers_to_xbar_ARREADY),
        .M_AXI_arvalid(s00_couplers_to_xbar_ARVALID),
        .M_AXI_awaddr(s00_couplers_to_xbar_AWADDR),
        .M_AXI_awprot(s00_couplers_to_xbar_AWPROT),
        .M_AXI_awready(s00_couplers_to_xbar_AWREADY),
        .M_AXI_awvalid(s00_couplers_to_xbar_AWVALID),
        .M_AXI_bready(s00_couplers_to_xbar_BREADY),
        .M_AXI_bresp(s00_couplers_to_xbar_BRESP),
        .M_AXI_bvalid(s00_couplers_to_xbar_BVALID),
        .M_AXI_rdata(s00_couplers_to_xbar_RDATA),
        .M_AXI_rready(s00_couplers_to_xbar_RREADY),
        .M_AXI_rresp(s00_couplers_to_xbar_RRESP),
        .M_AXI_rvalid(s00_couplers_to_xbar_RVALID),
        .M_AXI_wdata(s00_couplers_to_xbar_WDATA),
        .M_AXI_wready(s00_couplers_to_xbar_WREADY),
        .M_AXI_wstrb(s00_couplers_to_xbar_WSTRB),
        .M_AXI_wvalid(s00_couplers_to_xbar_WVALID),
        .S_ACLK(S00_ACLK_1),
        .S_ARESETN(S00_ARESETN_1),
        .S_AXI_araddr(microblaze_0_axi_periph_to_s00_couplers_ARADDR),
        .S_AXI_arprot(microblaze_0_axi_periph_to_s00_couplers_ARPROT),
        .S_AXI_arready(microblaze_0_axi_periph_to_s00_couplers_ARREADY),
        .S_AXI_arvalid(microblaze_0_axi_periph_to_s00_couplers_ARVALID),
        .S_AXI_awaddr(microblaze_0_axi_periph_to_s00_couplers_AWADDR),
        .S_AXI_awprot(microblaze_0_axi_periph_to_s00_couplers_AWPROT),
        .S_AXI_awready(microblaze_0_axi_periph_to_s00_couplers_AWREADY),
        .S_AXI_awvalid(microblaze_0_axi_periph_to_s00_couplers_AWVALID),
        .S_AXI_bready(microblaze_0_axi_periph_to_s00_couplers_BREADY),
        .S_AXI_bresp(microblaze_0_axi_periph_to_s00_couplers_BRESP),
        .S_AXI_bvalid(microblaze_0_axi_periph_to_s00_couplers_BVALID),
        .S_AXI_rdata(microblaze_0_axi_periph_to_s00_couplers_RDATA),
        .S_AXI_rready(microblaze_0_axi_periph_to_s00_couplers_RREADY),
        .S_AXI_rresp(microblaze_0_axi_periph_to_s00_couplers_RRESP),
        .S_AXI_rvalid(microblaze_0_axi_periph_to_s00_couplers_RVALID),
        .S_AXI_wdata(microblaze_0_axi_periph_to_s00_couplers_WDATA),
        .S_AXI_wready(microblaze_0_axi_periph_to_s00_couplers_WREADY),
        .S_AXI_wstrb(microblaze_0_axi_periph_to_s00_couplers_WSTRB),
        .S_AXI_wvalid(microblaze_0_axi_periph_to_s00_couplers_WVALID));
  Top_Level_Design_BD_xbar_0 xbar
       (.aclk(microblaze_0_axi_periph_ACLK_net),
        .aresetn(microblaze_0_axi_periph_ARESETN_net),
        .m_axi_araddr({xbar_to_m07_couplers_ARADDR,xbar_to_m06_couplers_ARADDR,xbar_to_m05_couplers_ARADDR,xbar_to_m04_couplers_ARADDR,xbar_to_m03_couplers_ARADDR,xbar_to_m02_couplers_ARADDR,xbar_to_m01_couplers_ARADDR,xbar_to_m00_couplers_ARADDR}),
        .m_axi_arprot({xbar_to_m05_couplers_ARPROT,xbar_to_m04_couplers_ARPROT,xbar_to_m03_couplers_ARPROT,xbar_to_m02_couplers_ARPROT,xbar_to_m01_couplers_ARPROT,NLW_xbar_m_axi_arprot_UNCONNECTED[2:0]}),
        .m_axi_arready({xbar_to_m07_couplers_ARREADY,xbar_to_m06_couplers_ARREADY,xbar_to_m05_couplers_ARREADY,xbar_to_m04_couplers_ARREADY,xbar_to_m03_couplers_ARREADY,xbar_to_m02_couplers_ARREADY,xbar_to_m01_couplers_ARREADY,xbar_to_m00_couplers_ARREADY}),
        .m_axi_arvalid({xbar_to_m07_couplers_ARVALID,xbar_to_m06_couplers_ARVALID,xbar_to_m05_couplers_ARVALID,xbar_to_m04_couplers_ARVALID,xbar_to_m03_couplers_ARVALID,xbar_to_m02_couplers_ARVALID,xbar_to_m01_couplers_ARVALID,xbar_to_m00_couplers_ARVALID}),
        .m_axi_awaddr({xbar_to_m07_couplers_AWADDR,xbar_to_m06_couplers_AWADDR,xbar_to_m05_couplers_AWADDR,xbar_to_m04_couplers_AWADDR,xbar_to_m03_couplers_AWADDR,xbar_to_m02_couplers_AWADDR,xbar_to_m01_couplers_AWADDR,xbar_to_m00_couplers_AWADDR}),
        .m_axi_awprot({xbar_to_m05_couplers_AWPROT,xbar_to_m04_couplers_AWPROT,xbar_to_m03_couplers_AWPROT,xbar_to_m02_couplers_AWPROT,xbar_to_m01_couplers_AWPROT,NLW_xbar_m_axi_awprot_UNCONNECTED[2:0]}),
        .m_axi_awready({xbar_to_m07_couplers_AWREADY,xbar_to_m06_couplers_AWREADY,xbar_to_m05_couplers_AWREADY,xbar_to_m04_couplers_AWREADY,xbar_to_m03_couplers_AWREADY,xbar_to_m02_couplers_AWREADY,xbar_to_m01_couplers_AWREADY,xbar_to_m00_couplers_AWREADY}),
        .m_axi_awvalid({xbar_to_m07_couplers_AWVALID,xbar_to_m06_couplers_AWVALID,xbar_to_m05_couplers_AWVALID,xbar_to_m04_couplers_AWVALID,xbar_to_m03_couplers_AWVALID,xbar_to_m02_couplers_AWVALID,xbar_to_m01_couplers_AWVALID,xbar_to_m00_couplers_AWVALID}),
        .m_axi_bready({xbar_to_m07_couplers_BREADY,xbar_to_m06_couplers_BREADY,xbar_to_m05_couplers_BREADY,xbar_to_m04_couplers_BREADY,xbar_to_m03_couplers_BREADY,xbar_to_m02_couplers_BREADY,xbar_to_m01_couplers_BREADY,xbar_to_m00_couplers_BREADY}),
        .m_axi_bresp({xbar_to_m07_couplers_BRESP,xbar_to_m06_couplers_BRESP,xbar_to_m05_couplers_BRESP,xbar_to_m04_couplers_BRESP,xbar_to_m03_couplers_BRESP,xbar_to_m02_couplers_BRESP,xbar_to_m01_couplers_BRESP,xbar_to_m00_couplers_BRESP}),
        .m_axi_bvalid({xbar_to_m07_couplers_BVALID,xbar_to_m06_couplers_BVALID,xbar_to_m05_couplers_BVALID,xbar_to_m04_couplers_BVALID,xbar_to_m03_couplers_BVALID,xbar_to_m02_couplers_BVALID,xbar_to_m01_couplers_BVALID,xbar_to_m00_couplers_BVALID}),
        .m_axi_rdata({xbar_to_m07_couplers_RDATA,xbar_to_m06_couplers_RDATA,xbar_to_m05_couplers_RDATA,xbar_to_m04_couplers_RDATA,xbar_to_m03_couplers_RDATA,xbar_to_m02_couplers_RDATA,xbar_to_m01_couplers_RDATA,xbar_to_m00_couplers_RDATA}),
        .m_axi_rready({xbar_to_m07_couplers_RREADY,xbar_to_m06_couplers_RREADY,xbar_to_m05_couplers_RREADY,xbar_to_m04_couplers_RREADY,xbar_to_m03_couplers_RREADY,xbar_to_m02_couplers_RREADY,xbar_to_m01_couplers_RREADY,xbar_to_m00_couplers_RREADY}),
        .m_axi_rresp({xbar_to_m07_couplers_RRESP,xbar_to_m06_couplers_RRESP,xbar_to_m05_couplers_RRESP,xbar_to_m04_couplers_RRESP,xbar_to_m03_couplers_RRESP,xbar_to_m02_couplers_RRESP,xbar_to_m01_couplers_RRESP,xbar_to_m00_couplers_RRESP}),
        .m_axi_rvalid({xbar_to_m07_couplers_RVALID,xbar_to_m06_couplers_RVALID,xbar_to_m05_couplers_RVALID,xbar_to_m04_couplers_RVALID,xbar_to_m03_couplers_RVALID,xbar_to_m02_couplers_RVALID,xbar_to_m01_couplers_RVALID,xbar_to_m00_couplers_RVALID}),
        .m_axi_wdata({xbar_to_m07_couplers_WDATA,xbar_to_m06_couplers_WDATA,xbar_to_m05_couplers_WDATA,xbar_to_m04_couplers_WDATA,xbar_to_m03_couplers_WDATA,xbar_to_m02_couplers_WDATA,xbar_to_m01_couplers_WDATA,xbar_to_m00_couplers_WDATA}),
        .m_axi_wready({xbar_to_m07_couplers_WREADY,xbar_to_m06_couplers_WREADY,xbar_to_m05_couplers_WREADY,xbar_to_m04_couplers_WREADY,xbar_to_m03_couplers_WREADY,xbar_to_m02_couplers_WREADY,xbar_to_m01_couplers_WREADY,xbar_to_m00_couplers_WREADY}),
        .m_axi_wstrb({xbar_to_m07_couplers_WSTRB,xbar_to_m06_couplers_WSTRB,xbar_to_m05_couplers_WSTRB,xbar_to_m04_couplers_WSTRB,xbar_to_m03_couplers_WSTRB,xbar_to_m02_couplers_WSTRB,xbar_to_m01_couplers_WSTRB,xbar_to_m00_couplers_WSTRB}),
        .m_axi_wvalid({xbar_to_m07_couplers_WVALID,xbar_to_m06_couplers_WVALID,xbar_to_m05_couplers_WVALID,xbar_to_m04_couplers_WVALID,xbar_to_m03_couplers_WVALID,xbar_to_m02_couplers_WVALID,xbar_to_m01_couplers_WVALID,xbar_to_m00_couplers_WVALID}),
        .s_axi_araddr(s00_couplers_to_xbar_ARADDR),
        .s_axi_arprot(s00_couplers_to_xbar_ARPROT),
        .s_axi_arready(s00_couplers_to_xbar_ARREADY),
        .s_axi_arvalid(s00_couplers_to_xbar_ARVALID),
        .s_axi_awaddr(s00_couplers_to_xbar_AWADDR),
        .s_axi_awprot(s00_couplers_to_xbar_AWPROT),
        .s_axi_awready(s00_couplers_to_xbar_AWREADY),
        .s_axi_awvalid(s00_couplers_to_xbar_AWVALID),
        .s_axi_bready(s00_couplers_to_xbar_BREADY),
        .s_axi_bresp(s00_couplers_to_xbar_BRESP),
        .s_axi_bvalid(s00_couplers_to_xbar_BVALID),
        .s_axi_rdata(s00_couplers_to_xbar_RDATA),
        .s_axi_rready(s00_couplers_to_xbar_RREADY),
        .s_axi_rresp(s00_couplers_to_xbar_RRESP),
        .s_axi_rvalid(s00_couplers_to_xbar_RVALID),
        .s_axi_wdata(s00_couplers_to_xbar_WDATA),
        .s_axi_wready(s00_couplers_to_xbar_WREADY),
        .s_axi_wstrb(s00_couplers_to_xbar_WSTRB),
        .s_axi_wvalid(s00_couplers_to_xbar_WVALID));
endmodule

module m00_couplers_imp_5YRABW
   (M_ACLK,
    M_ARESETN,
    M_AXI_araddr,
    M_AXI_arready,
    M_AXI_arvalid,
    M_AXI_awaddr,
    M_AXI_awready,
    M_AXI_awvalid,
    M_AXI_bready,
    M_AXI_bresp,
    M_AXI_bvalid,
    M_AXI_rdata,
    M_AXI_rready,
    M_AXI_rresp,
    M_AXI_rvalid,
    M_AXI_wdata,
    M_AXI_wready,
    M_AXI_wstrb,
    M_AXI_wvalid,
    S_ACLK,
    S_ARESETN,
    S_AXI_araddr,
    S_AXI_arready,
    S_AXI_arvalid,
    S_AXI_awaddr,
    S_AXI_awready,
    S_AXI_awvalid,
    S_AXI_bready,
    S_AXI_bresp,
    S_AXI_bvalid,
    S_AXI_rdata,
    S_AXI_rready,
    S_AXI_rresp,
    S_AXI_rvalid,
    S_AXI_wdata,
    S_AXI_wready,
    S_AXI_wstrb,
    S_AXI_wvalid);
  input M_ACLK;
  input [0:0]M_ARESETN;
  output [31:0]M_AXI_araddr;
  input M_AXI_arready;
  output M_AXI_arvalid;
  output [31:0]M_AXI_awaddr;
  input M_AXI_awready;
  output M_AXI_awvalid;
  output M_AXI_bready;
  input [1:0]M_AXI_bresp;
  input M_AXI_bvalid;
  input [31:0]M_AXI_rdata;
  output M_AXI_rready;
  input [1:0]M_AXI_rresp;
  input M_AXI_rvalid;
  output [31:0]M_AXI_wdata;
  input M_AXI_wready;
  output [3:0]M_AXI_wstrb;
  output M_AXI_wvalid;
  input S_ACLK;
  input [0:0]S_ARESETN;
  input [31:0]S_AXI_araddr;
  output S_AXI_arready;
  input S_AXI_arvalid;
  input [31:0]S_AXI_awaddr;
  output S_AXI_awready;
  input S_AXI_awvalid;
  input S_AXI_bready;
  output [1:0]S_AXI_bresp;
  output S_AXI_bvalid;
  output [31:0]S_AXI_rdata;
  input S_AXI_rready;
  output [1:0]S_AXI_rresp;
  output S_AXI_rvalid;
  input [31:0]S_AXI_wdata;
  output S_AXI_wready;
  input [3:0]S_AXI_wstrb;
  input S_AXI_wvalid;

  wire [31:0]m00_couplers_to_m00_couplers_ARADDR;
  wire m00_couplers_to_m00_couplers_ARREADY;
  wire m00_couplers_to_m00_couplers_ARVALID;
  wire [31:0]m00_couplers_to_m00_couplers_AWADDR;
  wire m00_couplers_to_m00_couplers_AWREADY;
  wire m00_couplers_to_m00_couplers_AWVALID;
  wire m00_couplers_to_m00_couplers_BREADY;
  wire [1:0]m00_couplers_to_m00_couplers_BRESP;
  wire m00_couplers_to_m00_couplers_BVALID;
  wire [31:0]m00_couplers_to_m00_couplers_RDATA;
  wire m00_couplers_to_m00_couplers_RREADY;
  wire [1:0]m00_couplers_to_m00_couplers_RRESP;
  wire m00_couplers_to_m00_couplers_RVALID;
  wire [31:0]m00_couplers_to_m00_couplers_WDATA;
  wire m00_couplers_to_m00_couplers_WREADY;
  wire [3:0]m00_couplers_to_m00_couplers_WSTRB;
  wire m00_couplers_to_m00_couplers_WVALID;

  assign M_AXI_araddr[31:0] = m00_couplers_to_m00_couplers_ARADDR;
  assign M_AXI_arvalid = m00_couplers_to_m00_couplers_ARVALID;
  assign M_AXI_awaddr[31:0] = m00_couplers_to_m00_couplers_AWADDR;
  assign M_AXI_awvalid = m00_couplers_to_m00_couplers_AWVALID;
  assign M_AXI_bready = m00_couplers_to_m00_couplers_BREADY;
  assign M_AXI_rready = m00_couplers_to_m00_couplers_RREADY;
  assign M_AXI_wdata[31:0] = m00_couplers_to_m00_couplers_WDATA;
  assign M_AXI_wstrb[3:0] = m00_couplers_to_m00_couplers_WSTRB;
  assign M_AXI_wvalid = m00_couplers_to_m00_couplers_WVALID;
  assign S_AXI_arready = m00_couplers_to_m00_couplers_ARREADY;
  assign S_AXI_awready = m00_couplers_to_m00_couplers_AWREADY;
  assign S_AXI_bresp[1:0] = m00_couplers_to_m00_couplers_BRESP;
  assign S_AXI_bvalid = m00_couplers_to_m00_couplers_BVALID;
  assign S_AXI_rdata[31:0] = m00_couplers_to_m00_couplers_RDATA;
  assign S_AXI_rresp[1:0] = m00_couplers_to_m00_couplers_RRESP;
  assign S_AXI_rvalid = m00_couplers_to_m00_couplers_RVALID;
  assign S_AXI_wready = m00_couplers_to_m00_couplers_WREADY;
  assign m00_couplers_to_m00_couplers_ARADDR = S_AXI_araddr[31:0];
  assign m00_couplers_to_m00_couplers_ARREADY = M_AXI_arready;
  assign m00_couplers_to_m00_couplers_ARVALID = S_AXI_arvalid;
  assign m00_couplers_to_m00_couplers_AWADDR = S_AXI_awaddr[31:0];
  assign m00_couplers_to_m00_couplers_AWREADY = M_AXI_awready;
  assign m00_couplers_to_m00_couplers_AWVALID = S_AXI_awvalid;
  assign m00_couplers_to_m00_couplers_BREADY = S_AXI_bready;
  assign m00_couplers_to_m00_couplers_BRESP = M_AXI_bresp[1:0];
  assign m00_couplers_to_m00_couplers_BVALID = M_AXI_bvalid;
  assign m00_couplers_to_m00_couplers_RDATA = M_AXI_rdata[31:0];
  assign m00_couplers_to_m00_couplers_RREADY = S_AXI_rready;
  assign m00_couplers_to_m00_couplers_RRESP = M_AXI_rresp[1:0];
  assign m00_couplers_to_m00_couplers_RVALID = M_AXI_rvalid;
  assign m00_couplers_to_m00_couplers_WDATA = S_AXI_wdata[31:0];
  assign m00_couplers_to_m00_couplers_WREADY = M_AXI_wready;
  assign m00_couplers_to_m00_couplers_WSTRB = S_AXI_wstrb[3:0];
  assign m00_couplers_to_m00_couplers_WVALID = S_AXI_wvalid;
endmodule
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
