linkejian123/G9_UofTSARBot/src/Top_Level_Design/bd/Top_Level_Design_BD/ip/Top_Level_Design_BD_axi_uartlite_0_0/axi_lite_ipif_v3_0_4/hdl/src/vhdl/address_decoder.vhd

-------------------------------------------------------------------
-- (c) Copyright 1984 - 2012 Xilinx, Inc. All rights reserved.
--
-- This file contains confidential and proprietary information
-- of Xilinx, Inc. and is protected under U.S. and
-- international copyright and other intellectual property
-- laws.
--
-- DISCLAIMER
-- This disclaimer is not a license and does not grant any
-- rights to the materials distributed herewith. Except as
-- otherwise provided in a valid license issued to you by
-- Xilinx, and to the maximum extent permitted by applicable
-- law: (1) THESE MATERIALS ARE MADE AVAILABLE "AS IS" AND
-- WITH ALL FAULTS, AND XILINX HEREBY DISCLAIMS ALL WARRANTIES
-- AND CONDITIONS, EXPRESS, IMPLIED, OR STATUTORY, INCLUDING
-- BUT NOT LIMITED TO WARRANTIES OF MERCHANTABILITY, NON-
-- INFRINGEMENT, OR FITNESS FOR ANY PARTICULAR PURPOSE; and
-- (2) Xilinx shall not be liable (whether in contract or tort,
-- including negligence, or under any other theory of
-- liability) for any loss or damage of any kind or nature
-- related to, arising under or in connection with these
-- materials, including for any direct, or any indirect,
-- special, incidental, or consequential loss or damage
-- (including loss of data, profits, goodwill, or any type of
-- loss or damage suffered as a result of any action brought
-- by a third party) even if such damage or loss was
-- reasonably foreseeable or Xilinx had been advised of the
-- possibility of the same.
--
-- CRITICAL APPLICATIONS
-- Xilinx products are not designed or intended to be fail-
-- safe, or for use in any application requiring fail-safe
-- performance, such as life-support or safety devices or
-- systems, Class III medical devices, nuclear facilities,
-- applications related to the deployment of airbags, or any
-- other applications that could lead to death, personal
-- injury, or severe property or environmental damage
-- (individually and collectively, "Critical
-- Applications"). Customer assumes the sole risk and
-- liability of any use of Xilinx products in Critical
-- Applications, subject only to applicable laws and
-- regulations governing limitations on product liability.
--
-- THIS COPYRIGHT NOTICE AND DISCLAIMER MUST BE RETAINED AS
-- PART OF THIS FILE AT ALL TIMES.
-------------------------------------------------------------------
-- ************************************************************************
--
-------------------------------------------------------------------------------
-- Filename:        address_decoder.vhd
-- Version:         v2.0
-- Description:     Address decoder utilizing unconstrained arrays for Base
--                  Address specification and ce number.
-------------------------------------------------------------------------------
-- Structure:   This section shows the hierarchical structure of axi_lite_ipif.
--
--              --axi_lite_ipif.vhd
--                    --slave_attachment.vhd
--                       --address_decoder.vhd
-------------------------------------------------------------------------------
-- Author:      BSB
--
-- History:
--
--  BSB      05/20/10      -- First version
-- ~~~~~~
--  - Created the first version v1.00.a
-- ^^^^^^
-- ~~~~~~
--  SK       08/09/2010    --
--  - updated the core with optimziation. Closed CR 574507
--  - combined the CE generation logic to further optimize the code.
-- ^^^^^^
-- ~~~~~~
--  SK       12/16/12      -- v2.0
--  1. up reved to major version for 2013.1 Vivado release. No logic updates.
--  2. Updated the version of AXI LITE IPIF to v2.0 in X.Y format
--  3. updated the proc common version to proc_common_base_v5_0
--  4. No Logic Updates
-- ^^^^^^
-------------------------------------------------------------------------------
-- Naming Conventions:
--      active low signals:                     "*_n"
--      clock signals:                          "clk", "clk_div#", "clk_#x"
--      reset signals:                          "rst", "rst_n"
--      generics:                               "C_*"
--      user defined types:                     "*_TYPE"
--      state machine next state:               "*_ns"
--      state machine current state:            "*_cs"
--      combinatorial signals:                  "*_cmb"
--      pipelined or register delay signals:    "*_d#"
--      counter signals:                        "*cnt*"
--      clock enable signals:                   "*_ce"
--      internal version of output port         "*_i"
--      device pins:                            "*_pin"
--      ports:                                  - Names begin with Uppercase
--      processes:                              "*_PROCESS"
--      component instantiations:               "<ENTITY_>I_<#|FUNC>
-------------------------------------------------------------------------------

library IEEE;
use IEEE.std_logic_1164.all;
use ieee.numeric_std.all;

--library proc_common_base_v5_0;
--use proc_common_base_v5_0.proc_common_pkg.clog2;
--use proc_common_base_v5_0.pselect_f;
--use proc_common_base_v5_0.ipif_pkg.all;

library axi_lite_ipif_v3_0_4;
use axi_lite_ipif_v3_0_4.ipif_pkg.all;

-------------------------------------------------------------------------------
--                     Definition of Generics
-------------------------------------------------------------------------------
-- C_BUS_AWIDTH          -- Address bus width
-- C_S_AXI_MIN_SIZE      -- Minimum address range of the IP
-- C_ARD_ADDR_RANGE_ARRAY-- Base /High Address Pair for each Address Range
-- C_ARD_NUM_CE_ARRAY    -- Desired number of chip enables for an address range
-- C_FAMILY              -- Target FPGA family
-------------------------------------------------------------------------------
--                  Definition of Ports
-------------------------------------------------------------------------------
-- Bus_clk               -- Clock
-- Bus_rst               -- Reset
-- Address_In_Erly       -- Adddress in
-- Address_Valid_Erly    -- Address is valid
-- Bus_RNW               -- Read or write registered
-- Bus_RNW_Erly          -- Read or Write
-- CS_CE_ld_enable       -- chip select and chip enable registered
-- Clear_CS_CE_Reg       -- Clear_CS_CE_Reg clear
-- RW_CE_ld_enable       -- Read or Write Chip Enable
-- CS_for_gaps           -- CS generation for the gaps between address ranges
-- CS_Out                -- Chip select
-- RdCE_Out              -- Read Chip enable
-- WrCE_Out              -- Write chip enable
-------------------------------------------------------------------------------
-------------------------------------------------------------------------------
-- Entity Declaration
-------------------------------------------------------------------------------

entity address_decoder is
    generic (
        C_BUS_AWIDTH          : integer := 32;
        C_S_AXI_MIN_SIZE      : std_logic_vector(0 to 31) := X"000001FF";
        C_ARD_ADDR_RANGE_ARRAY: SLV64_ARRAY_TYPE :=
            (
             X"0000_0000_1000_0000", --  IP user0 base address
             X"0000_0000_1000_01FF", --  IP user0 high address
             X"0000_0000_1000_0200", --  IP user1 base address
             X"0000_0000_1000_02FF"  --  IP user1 high address
            );
        C_ARD_NUM_CE_ARRAY  : INTEGER_ARRAY_TYPE :=
            (
             8,     -- User0 CE Number
             1      -- User1 CE Number
            );
        C_FAMILY            : string  := "virtex6"
    );
  port (
        Bus_clk             : in  std_logic;
        Bus_rst             : in  std_logic;

        -- PLB Interface signals
        Address_In_Erly     : in  std_logic_vector(0 to C_BUS_AWIDTH-1);
        Address_Valid_Erly  : in  std_logic;
        Bus_RNW             : in  std_logic;
        Bus_RNW_Erly        : in  std_logic;

        -- Registering control signals
        CS_CE_ld_enable     : in  std_logic;
        Clear_CS_CE_Reg     : in  std_logic;
        RW_CE_ld_enable     : in  std_logic;
        CS_for_gaps         : out std_logic;
        -- Decode output signals
        CS_Out              : out std_logic_vector
                                (0 to ((C_ARD_ADDR_RANGE_ARRAY'LENGTH)/2)-1);
        RdCE_Out            : out std_logic_vector
                                (0 to calc_num_ce(C_ARD_NUM_CE_ARRAY)-1);
        WrCE_Out            : out std_logic_vector
                                (0 to calc_num_ce(C_ARD_NUM_CE_ARRAY)-1)
    );
end entity address_decoder;

-------------------------------------------------------------------------------
-- Architecture section
-------------------------------------------------------------------------------

architecture IMP of address_decoder is
----------------------------------------------------------------------------------
-- below attributes are added to reduce the synth warnings in Vivado tool
attribute DowngradeIPIdentifiedWarnings: string;
attribute DowngradeIPIdentifiedWarnings of imp : architecture is "yes";
----------------------------------------------------------------------------------

-- local type declarations ----------------------------------------------------
type decode_bit_array_type is Array(natural range 0 to (
                           (C_ARD_ADDR_RANGE_ARRAY'LENGTH)/2)-1) of
                           integer;

type short_addr_array_type is Array(natural range 0 to
                           C_ARD_ADDR_RANGE_ARRAY'LENGTH-1) of
                           std_logic_vector(0 to C_BUS_AWIDTH-1);
-------------------------------------------------------------------------------
-- Function Declarations
-------------------------------------------------------------------------------

-------------------------------------------------------------------------------
-- This function converts a 64 bit address range array to a AWIDTH bit
-- address range array.
-------------------------------------------------------------------------------
function slv64_2_slv_awidth(slv64_addr_array   : SLV64_ARRAY_TYPE;
                            awidth             : integer)
                        return short_addr_array_type is

    variable temp_addr   : std_logic_vector(0 to 63);
    variable slv_array   : short_addr_array_type;
    begin
        for array_index in 0 to slv64_addr_array'length-1 loop
            temp_addr := slv64_addr_array(array_index);
            slv_array(array_index) := temp_addr((64-awidth) to 63);
        end loop;
        return(slv_array);
    end function slv64_2_slv_awidth;

-------------------------------------------------------------------------------
--Function Addr_bits
--function to convert an address range (base address and an upper address)
--into the number of upper address bits needed for decoding a device
--select signal.  will handle slices and big or little endian
-------------------------------------------------------------------------------
function Addr_Bits (x,y : std_logic_vector(0 to C_BUS_AWIDTH-1))
                    return integer is
    variable addr_nor : std_logic_vector(0 to C_BUS_AWIDTH-1);
    begin
        addr_nor := x xor y;
        for i in 0 to C_BUS_AWIDTH-1 loop
            if addr_nor(i)='1' then
                return i;
            end if;
        end loop;
--coverage off
        return(C_BUS_AWIDTH);
--coverage on
    end function Addr_Bits;
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
