linkejian123/G9_UofTSARBot/(commit log)

2017-04-10 Added the Accelerometer IP package.
2017-04-10 Fixed the port issue of the Accelerometer IP block and added the Image Processing IP block.
    [Accelerometer_v1_0.v, Accelerometer_v1_0_Accelerometer_AXI.v, Accelerometer_v1_0_tb.v, I2C_AV_Config.v, I2C_Controller.v, I2C_OV7670_RGB444_Config.v, OV7670_Capture.sv, VGA_Accumulator.sv]
2017-04-10 Fixed a typo of the folder name for the temperature sensor.
2017-04-10 Added the Temperature Sensor IP block.
2017-04-10 Update README.md with an extra acknowledgement to PMOD camera.
